AnjaDj/2D_Space_Mapping/2DSpaceMapping_C/Testing/PCB voltages test/3V3 on PCB - 2.jpg

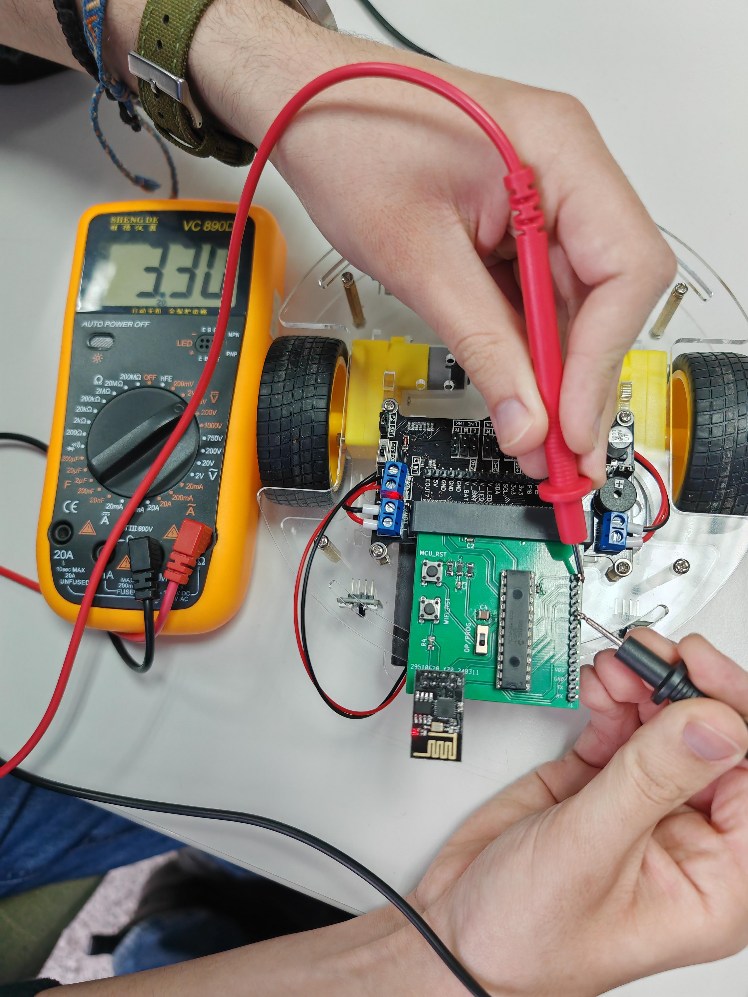
2DSpaceMapping_C/Testing/PCB voltages test/3V3 on PCB - 2.jpg
