AnjaDj/2D_Space_Mapping/README.md

Project Assignment "2D Space Mapping car with ability to move through a maze"
- obstacle detection
- avoiding obstacles
- 2D space mapping
