AnjaDj/2D_Space_Mapping/2DSpaceMapping_C/README.md

# 2DSpaceMapping autonomous vehicle 🚗 ➡️ HARDWARE SIDE

This is a hardware_branch which contains models for assembly electronic devices/ modules / components. <br />
For more detailed informations about each used modul, visit Wiki 📜 page. <br />
 <br />
## Currently implemented :
  - edge connector
  - MCU PIC24FJ64GA002-I/SP
  - normally opened button TS02-66-50-BK-100-SCR-D
  - WiFi module WRL-17146
  - Slide-Switch SLW-883935-2A-D
  - 2x4 pin socket for WiFi module 5-534206-4
  - MCU socket 1-2199298-9

## Guidance through file hierarchy :
  - Symbols_footprints ➡️ contains .kicad_sym & .kicad_mod files for each used modul / component on the scheme
  - pcb ➡️  contains .png screenshots of .kicad_pcb file
  - schema ➡️  contains .png screenshots of .kicad_sch file and .pdf file exported from KiCad project
  - work ➡️  project work directory. Run ♻️ the pcb_layout_c.kicad_pro form this directory using KiCad7.0 or latest. <br /> (KiCad DOWNLOAD link 🆓⬇️ : https://www.kicad.org/download/windows/)
  - components.csv ➡️ list of used components for this project with Mouser Electronics 🐁 link to each of them. <br /> (https://hr.mouser.com/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)

## KiCad Schema : 
schema
schema_left
schema_right

## KiCad PCB Layout: 
pcb

## KiCad 3D View PCB :
pcb3DView
pcb3DView2

## Guidance through Git Bash commands :
1. 		git checkout hardware_branch
2. 		git pull origin hardware_branch
3. 🚧 ...modification... 🚧
4. 		git add .
5. 		git commit -m "Issue#n
   		- Line1
   		- Line2
   		- ..."
     n  - the number of Issue being worked on
7. 		git push origin hardware_branch
