AnjaDj/2D_Space_Mapping/2DSpaceMapping_B/docs/pcb/layout_3d_model.pdf

Projektni zadatak iz predmeta Mikrokontrolerski sistemi/Računarska elektronika

1

### Elektrotehnički fakultet Univerzitet u Banjoj Luci

## DOKUMENTACIJA PROJEKTNOG ZADATKA

## iz predmeta

## MIKROKONTROLERSKI SISTEMI/RAČUNARSKA ELEKTRONIKA

Student: | Mentori:
Tripić, Nemanja | prof. dr Željko Ivanović
Legenović, Dajana | dipl. inž Damjan Prerad
Savković, Božana

Projektni zadatak iz predmeta Digitalna obrada signala - izvještaj

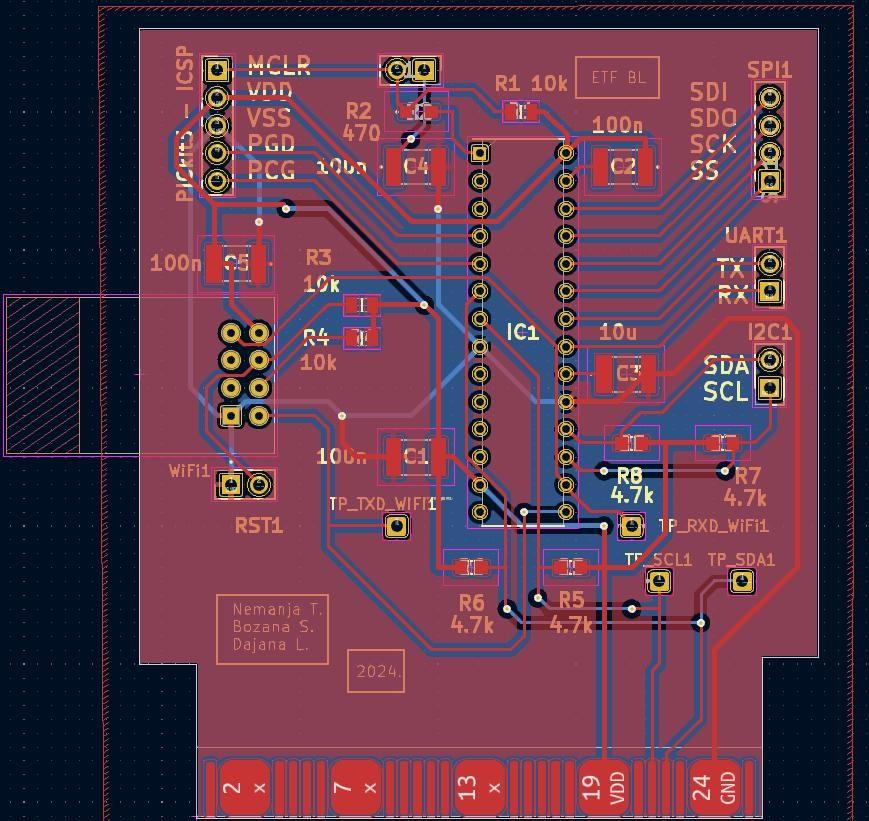
[picture p3: figure]

2

## RUTIRANJE KOMPONENATA

## Rutiranje komponenata

Nakon projektovanja šeme, potrebno je odraditi PCB layuot, rutirati komponente. Korišeno je dvoslojno rutiranje. Debljine linija za povezivanje su 0.254mm, a za napajanje 0.5mm. Minimalno rastojanje između komponenata je 0.1mm.

## Layout

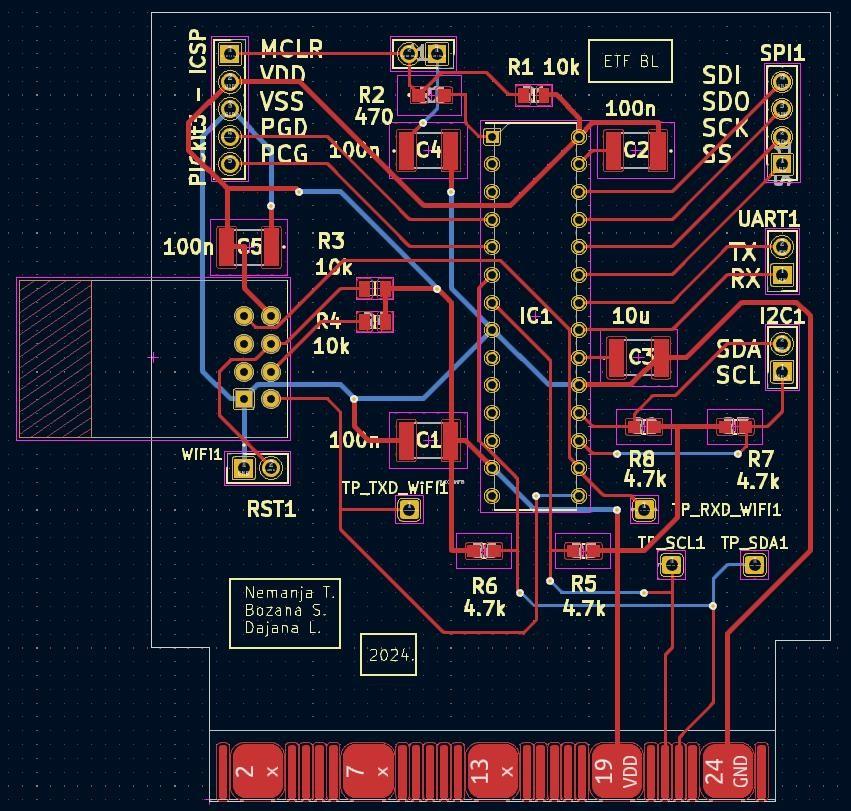
[picture p4: figure]

3

Prednja strana:

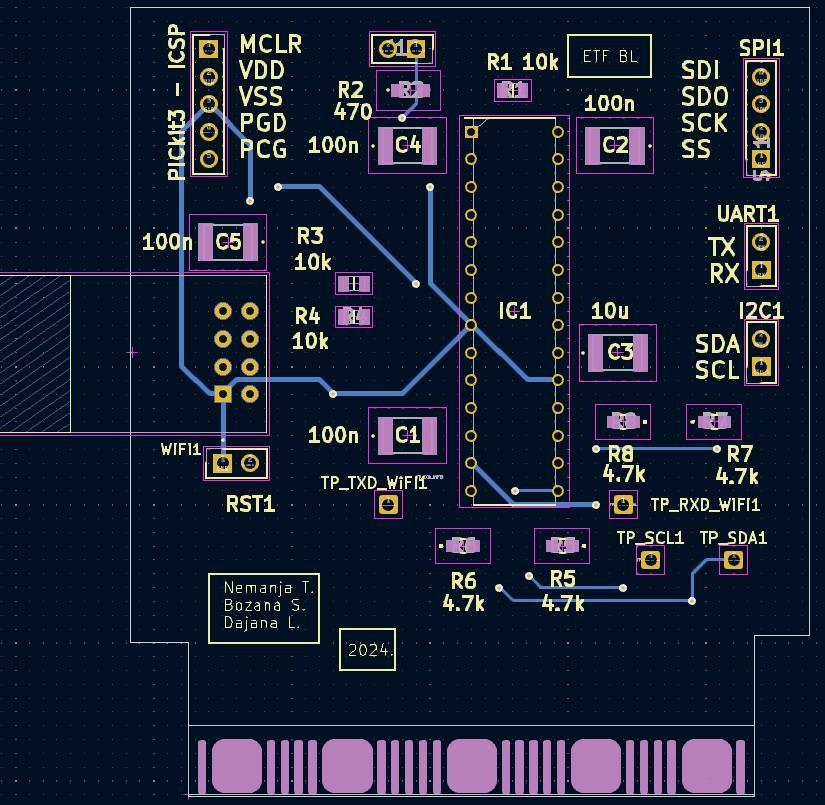
[picture p5: figure]

4

Zadnja strana:

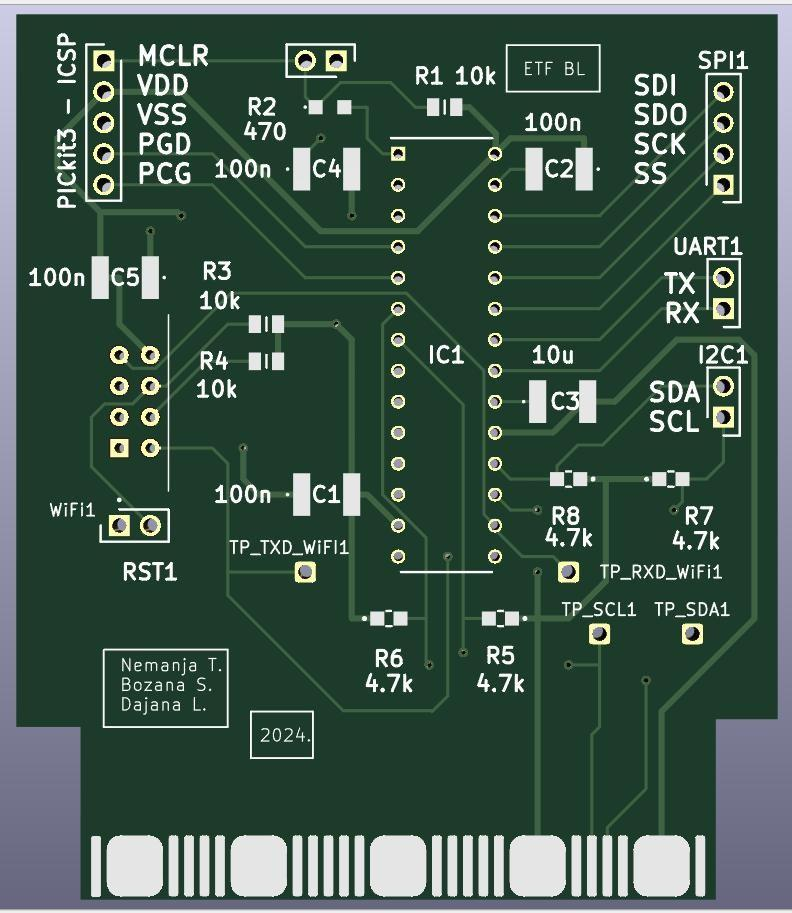
[picture p6: figure]

5

## 3D MODEL

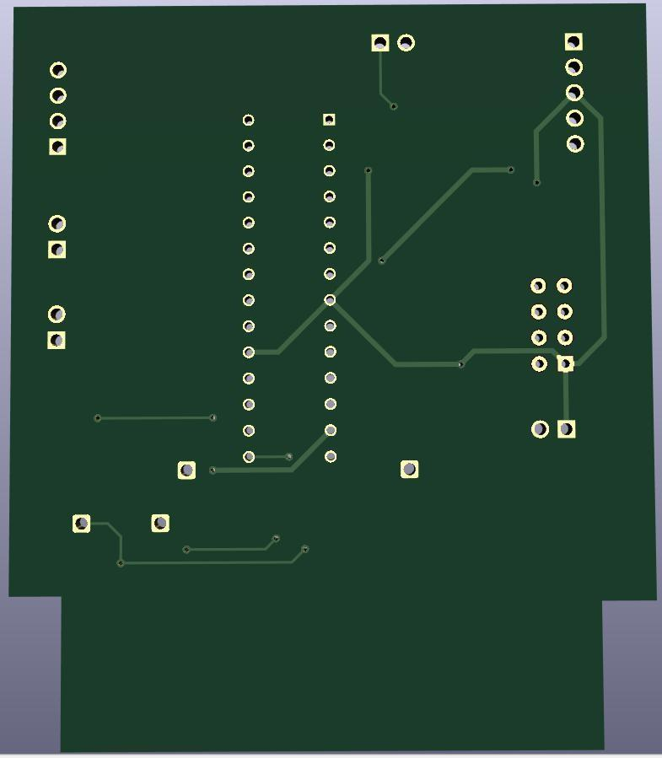
[picture p7: figure]

6

7
