AnjaDj/2D_Space_Mapping/2DSpaceMapping_B/software/2D_mapping_simulation/map1.png

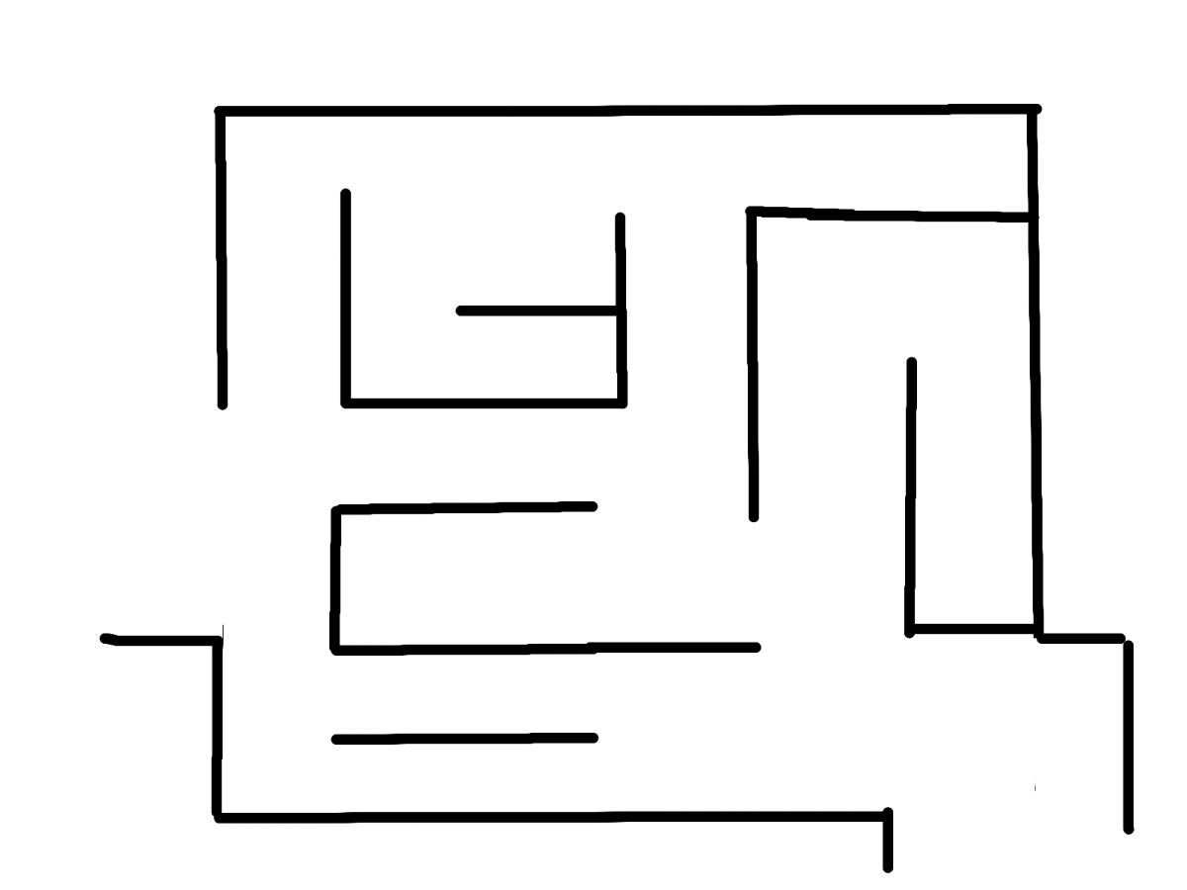
2DSpaceMapping_B/software/2D_mapping_simulation/map1.png
