AnjaDj/2D_Space_Mapping/2DSpaceMapping_C/pcb/pcb3DView2.png

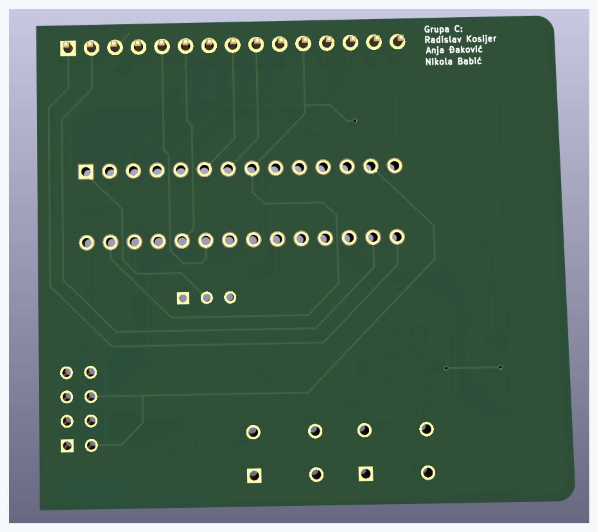
2DSpaceMapping_C/pcb/pcb3DView2.png
