AnjaDj/2D_Space_Mapping/2DSpaceMapping_C/pcb/pcb.png

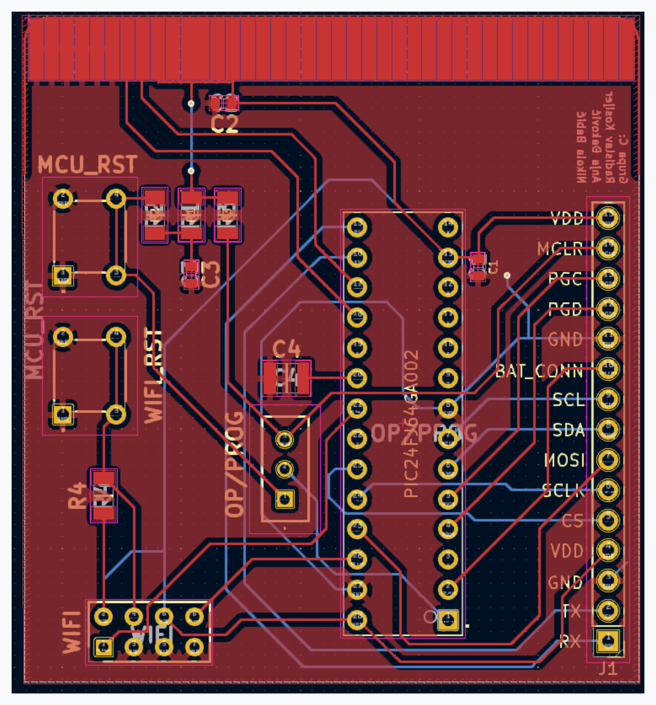
2DSpaceMapping_C/pcb/pcb.png
