AnjaDj/2D_Space_Mapping/2DSpaceMapping_C/schema/schema.png

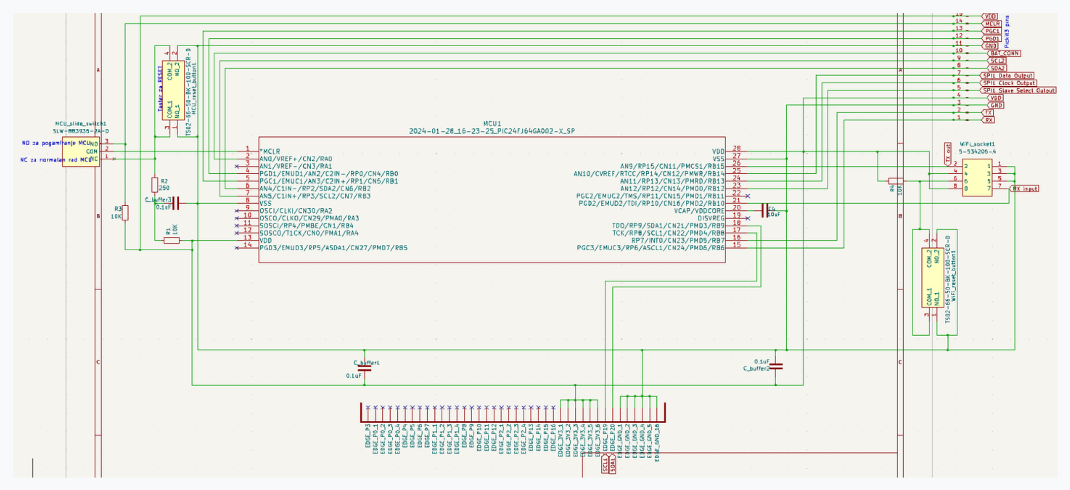
2DSpaceMapping_C/schema/schema.png
