AnjaDj/2D_Space_Mapping/2DSpaceMapping_C/schema/schema_right.png

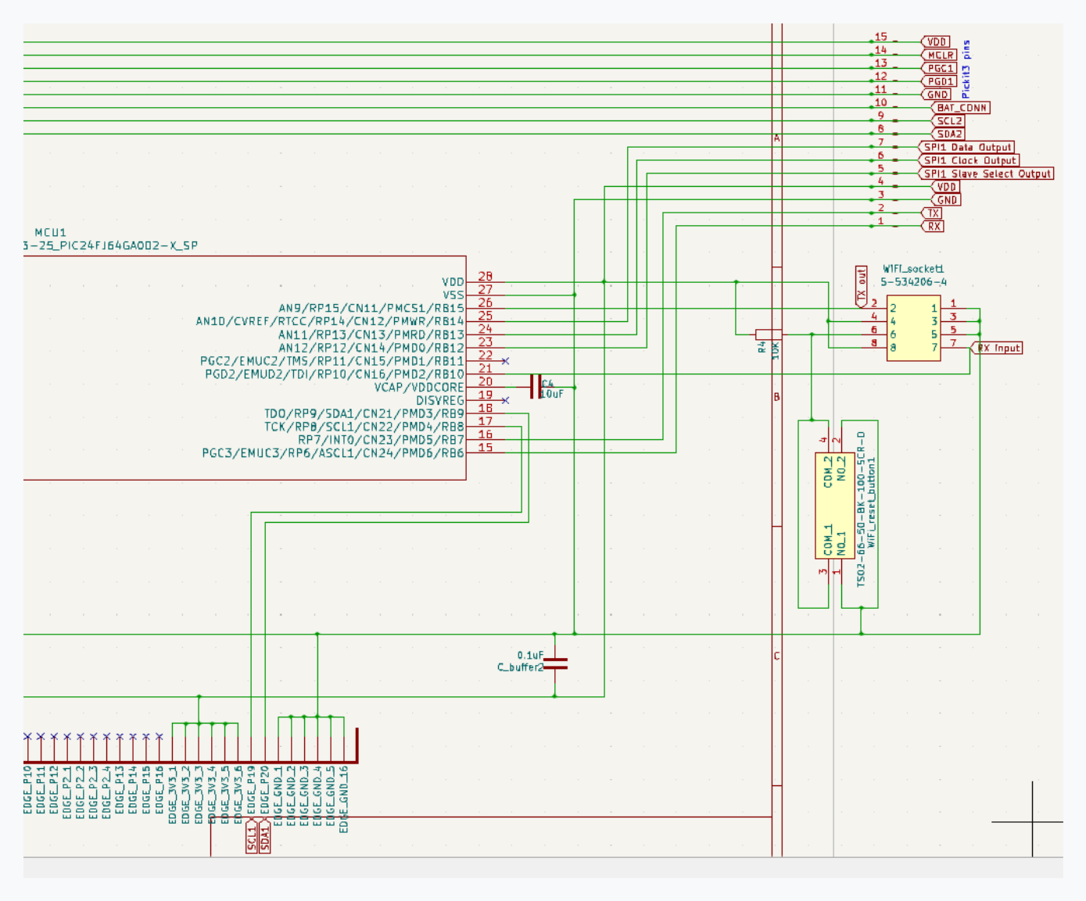
2DSpaceMapping_C/schema/schema_right.png
