AnjaDj/2D_Space_Mapping/2DSpaceMapping_A/kicad/sema_i_pcb/models/CAPACITORS_RESISTORS/100nF.stp

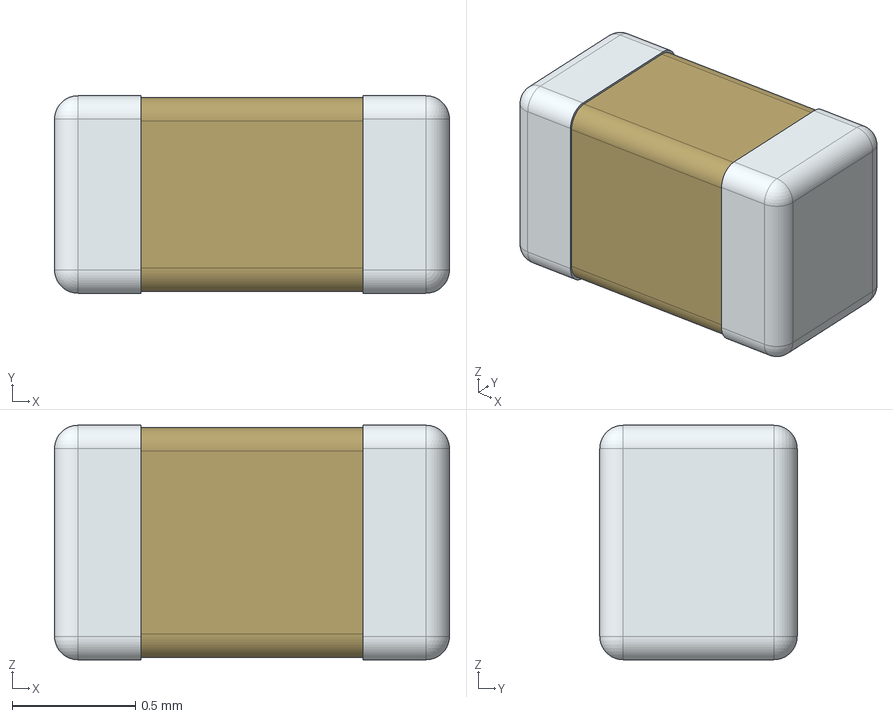
[picture p25: CAD file, 2024-08-02]
2DSpaceMapping_A/kicad/sema_i_pcb/models/CAPACITORS_RESISTORS/100nF.stp
1.60 x 0.8 x 0.95 mm
