AnjaDj/2D_Space_Mapping/2DSpaceMapping_A/kicad/sema_i_pcb/models/ESP8266/ESP8266-01_ESP-01.step

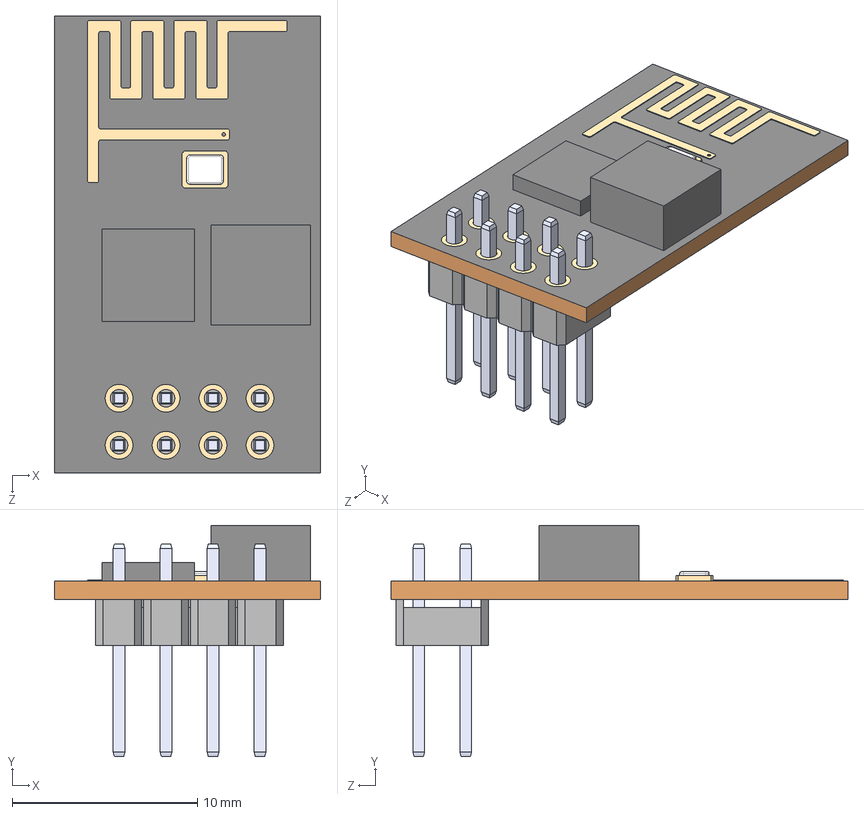
[picture p26: CAD file, 2024-08-02]
2DSpaceMapping_A/kicad/sema_i_pcb/models/ESP8266/ESP8266-01_ESP-01.step
14.4 x 12.5 x 24.7 mm
