AnjaDj/2D_Space_Mapping/2DSpaceMapping_A/kicad/sema_i_pcb/models/MCU/PIC24FJ64GA002-I_SO.STEP

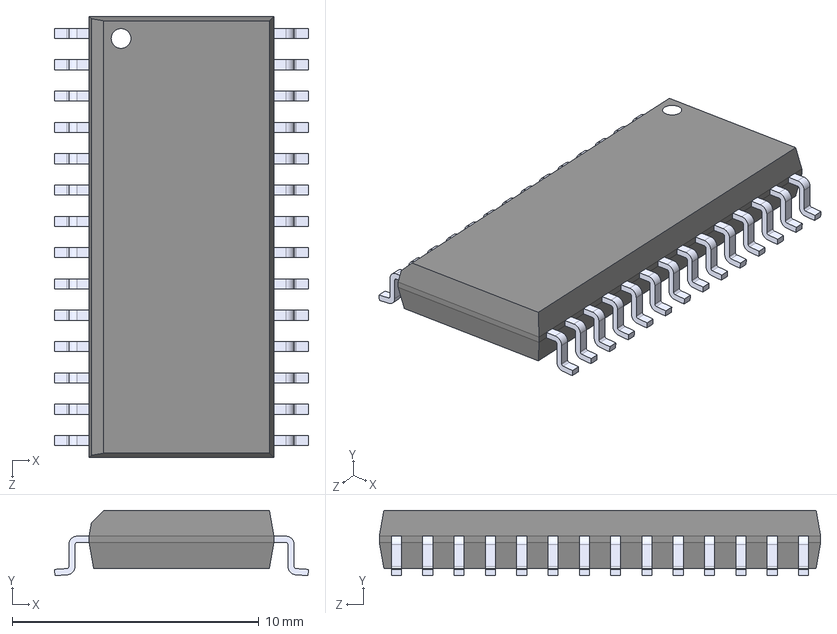
[picture p27: CAD file, 2024-08-02]
2DSpaceMapping_A/kicad/sema_i_pcb/models/MCU/PIC24FJ64GA002-I_SO.STEP
10.3 x 2.65 x 17.9 mm
