AnjaDj/2D_Space_Mapping/2DSpaceMapping_A/kicad/sema_i_pcb/models/PIN_HEADERS/A2-2PA-2.54DSA_71_.stp

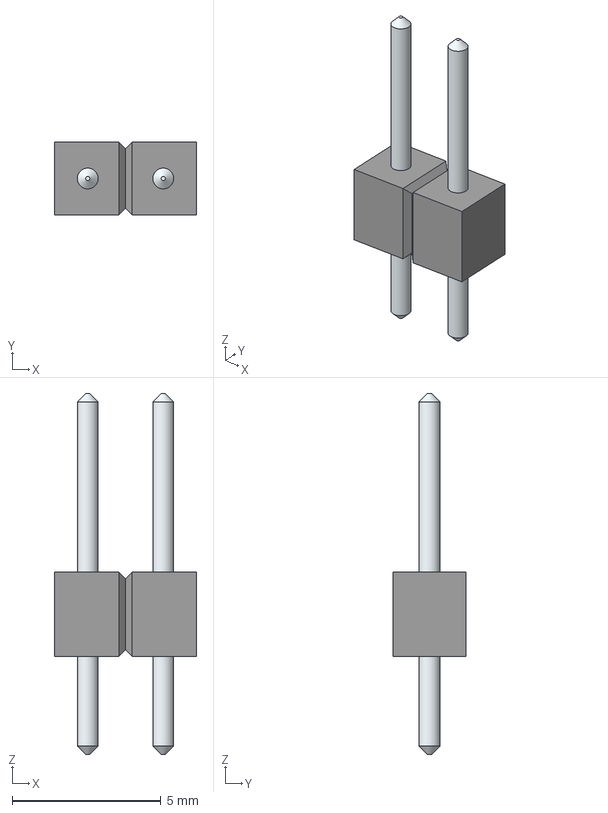
[picture p28: CAD file, 2024-08-02]
2DSpaceMapping_A/kicad/sema_i_pcb/models/PIN_HEADERS/A2-2PA-2.54DSA_71_.stp
4.78 x 2.44 x 12.1 mm
LeadsArray
