AnjaDj/2D_Space_Mapping/2DSpaceMapping_A/kicad/sema_i_pcb/models/PUSH_BUTTON/COM-12992.stp

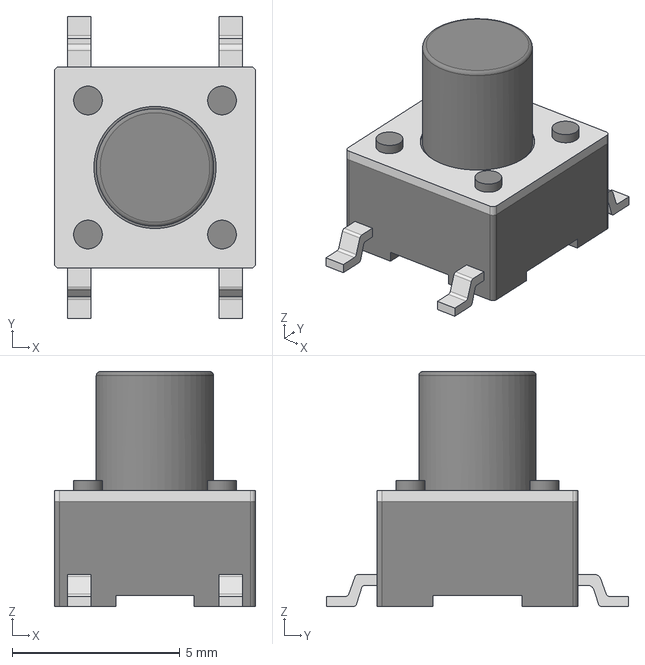
[picture p29: CAD file, 2024-08-02]
2DSpaceMapping_A/kicad/sema_i_pcb/models/PUSH_BUTTON/COM-12992.stp
6.00 x 9.00 x 7.00 mm
