AnjaDj/2D_Space_Mapping/2DSpaceMapping_A/kicad/sema_i_pcb/models/SPDT_SWITCH/SLW-1276864-4A-D.stp

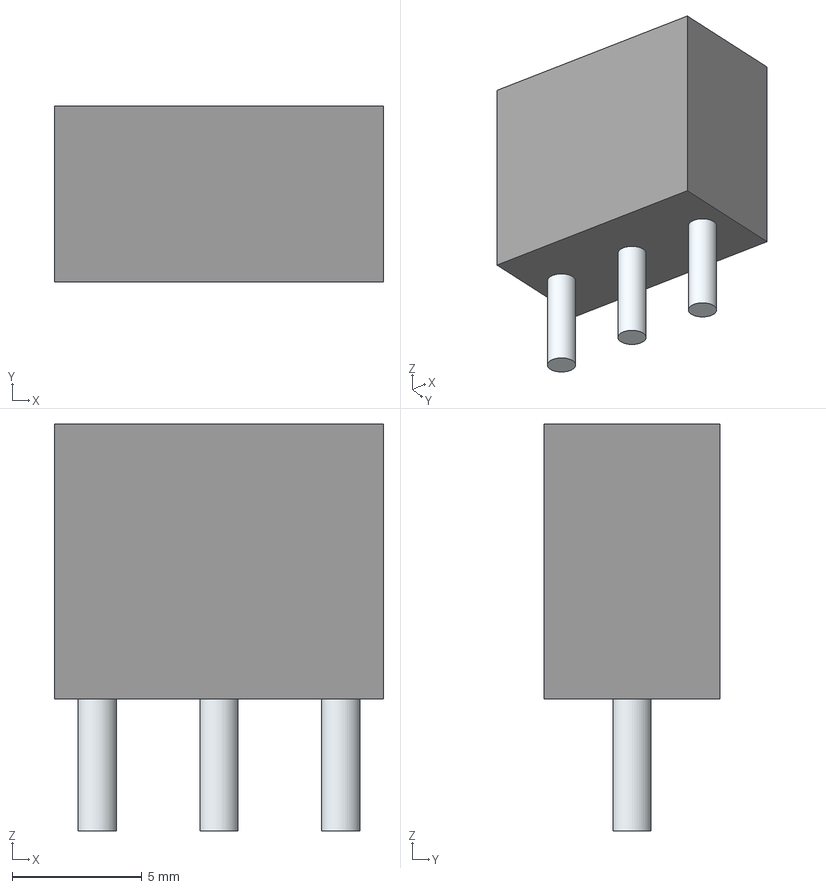
[picture p30: CAD file, 2024-08-02]
2DSpaceMapping_A/kicad/sema_i_pcb/models/SPDT_SWITCH/SLW-1276864-4A-D.stp
12.7 x 6.80 x 15.7 mm
Leads
