AnjaDj/2D_Space_Mapping/2DSpaceMapping_C/Symbols_footprints/mcu_socket_1-2199298-9/1-2199298-9.step

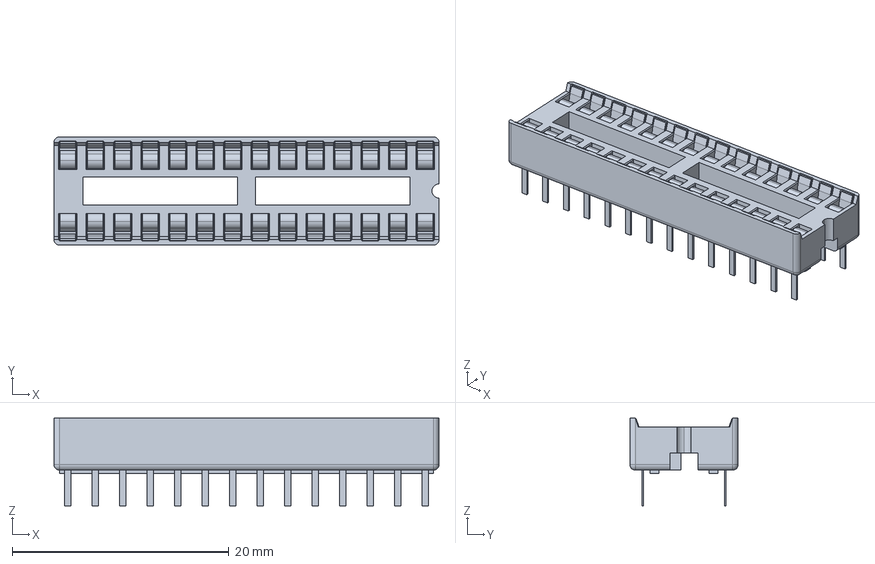
[picture p31: CAD file, 2024-08-02]
2DSpaceMapping_C/Symbols_footprints/mcu_socket_1-2199298-9/1-2199298-9.step
35.6 x 10.0 x 8.10 mm
