AnjaDj/2D_Space_Mapping/2DSpaceMapping_A/kicad/sema_i_pcb/models/CAPACITORS_RESISTORS/10k.stp

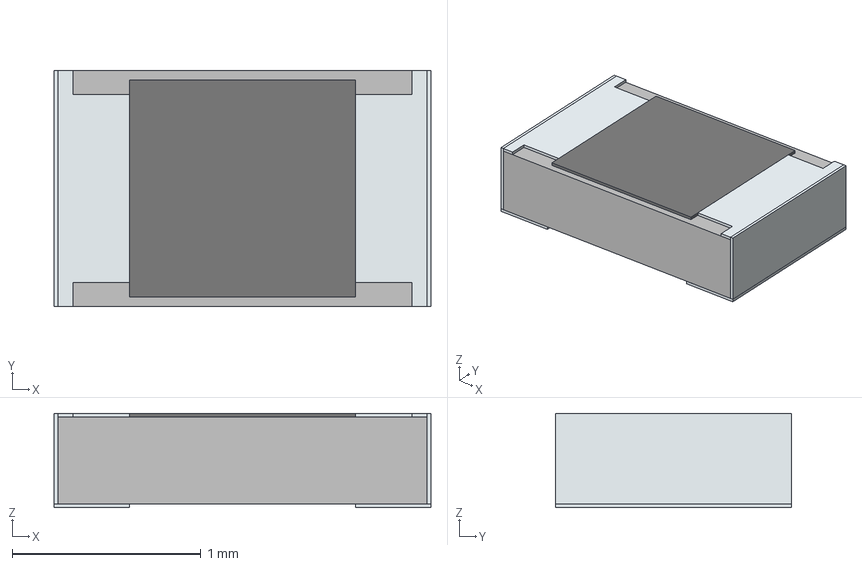
[picture p32: CAD file, 2024-08-02]
2DSpaceMapping_A/kicad/sema_i_pcb/models/CAPACITORS_RESISTORS/10k.stp
2.00 x 1.25 x 0.5 mm
solidBody
solidTop
solidTerminal1
solidTerminal2
solidTerminal3
