AnjaDj/2D_Space_Mapping/2DSpaceMapping_A/kicad/sema_i_pcb/models/PIN_HEADERS/A2-4PA-2.54DSA_71_.stp

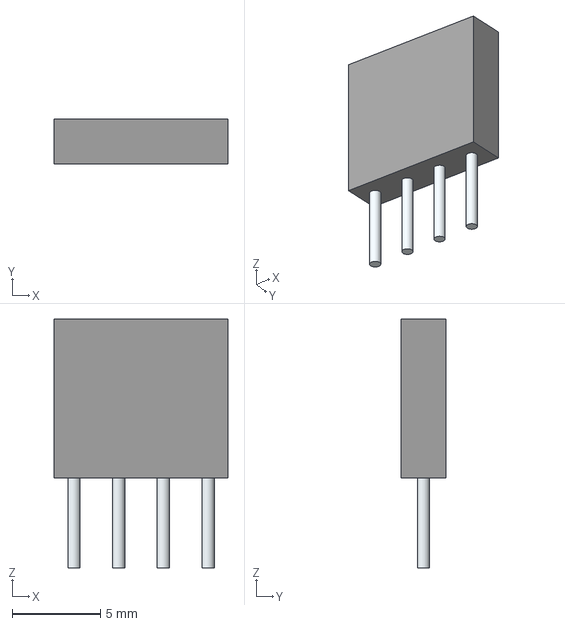
[picture p33: CAD file, 2024-08-02]
2DSpaceMapping_A/kicad/sema_i_pcb/models/PIN_HEADERS/A2-4PA-2.54DSA_71_.stp
9.86 x 2.54 x 14.1 mm
Leads x 4
