AnjaDj/2D_Space_Mapping/2DSpaceMapping_A/kicad/sema_i_pcb/models/CAPACITORS_RESISTORS/10uF.stp

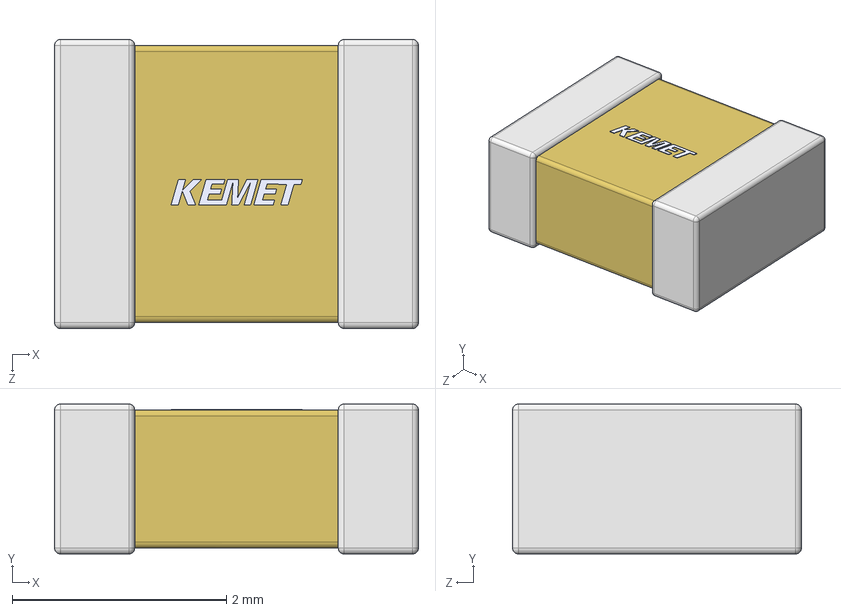
[picture p34: CAD file, 2024-08-02]
2DSpaceMapping_A/kicad/sema_i_pcb/models/CAPACITORS_RESISTORS/10uF.stp
3.40 x 1.40 x 2.70 mm
