AnjaDj/2D_Space_Mapping/2DSpaceMapping_A/kicad/sema_i_pcb/models/PIN_HEADERS/A2-5PA-2.54DSA_71_.stp

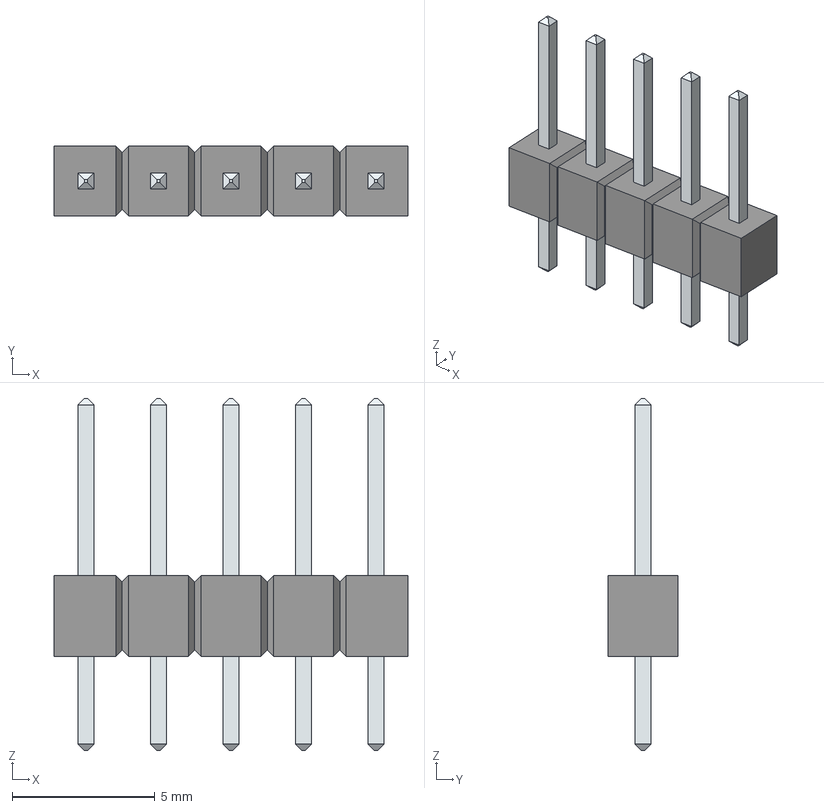
[picture p35: CAD file, 2024-08-02]
2DSpaceMapping_A/kicad/sema_i_pcb/models/PIN_HEADERS/A2-5PA-2.54DSA_71_.stp
12.4 x 2.44 x 12.3 mm
LeadsArray
