AnjaDj/2D_Space_Mapping/2DSpaceMapping_C/Testing/PCB voltages test/3V3 on Joy-Car board.jpg

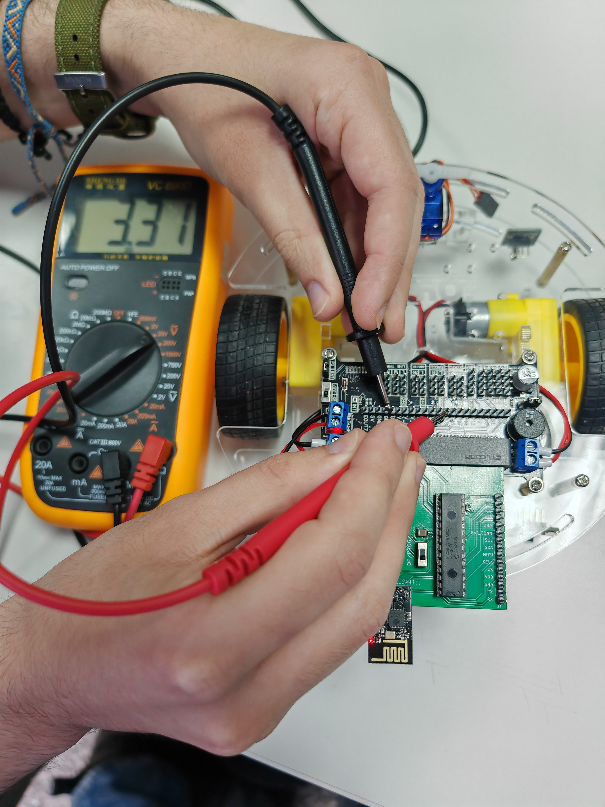
2DSpaceMapping_C/Testing/PCB voltages test/3V3 on Joy-Car board.jpg
