AnjaDj/2D_Space_Mapping/2DSpaceMapping_C/shema_layout_3dview.pdf

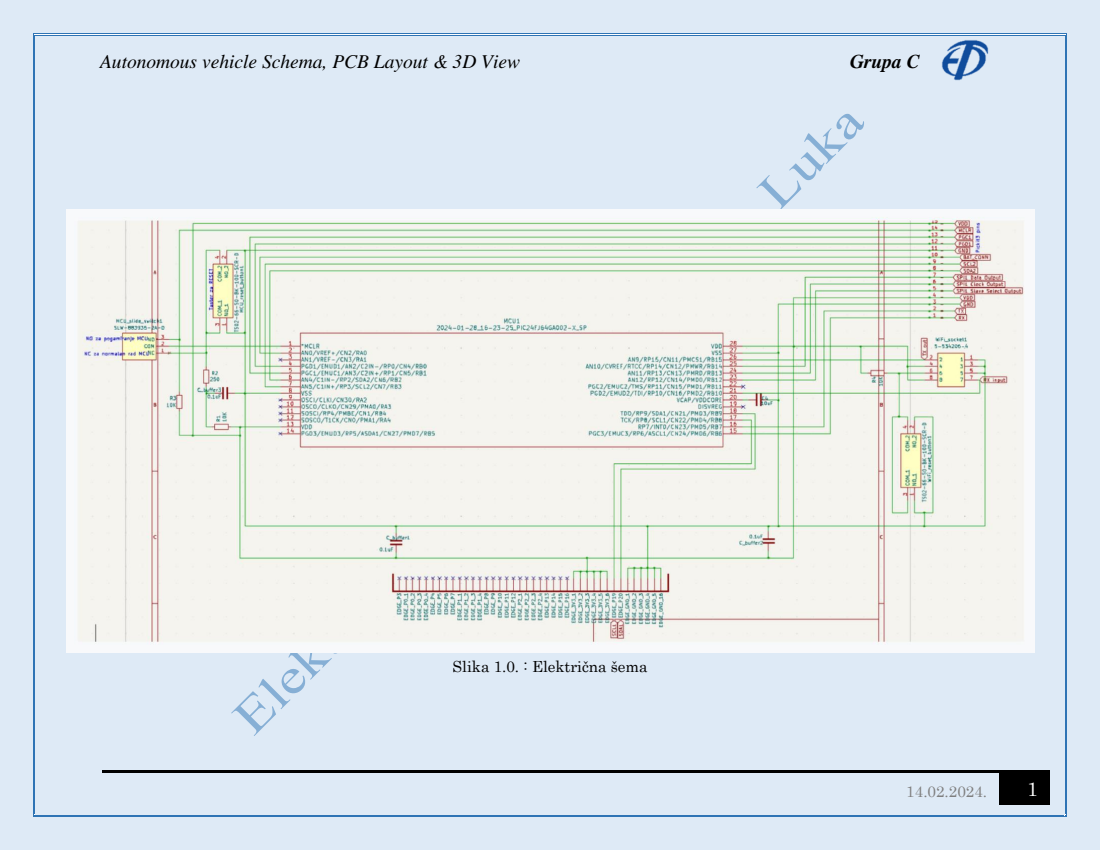
[picture p38: page 1]
Autonomous vehicle Schema, PCB Layout & 3D View; Grupa C

Slika 1.0. : Električna šema

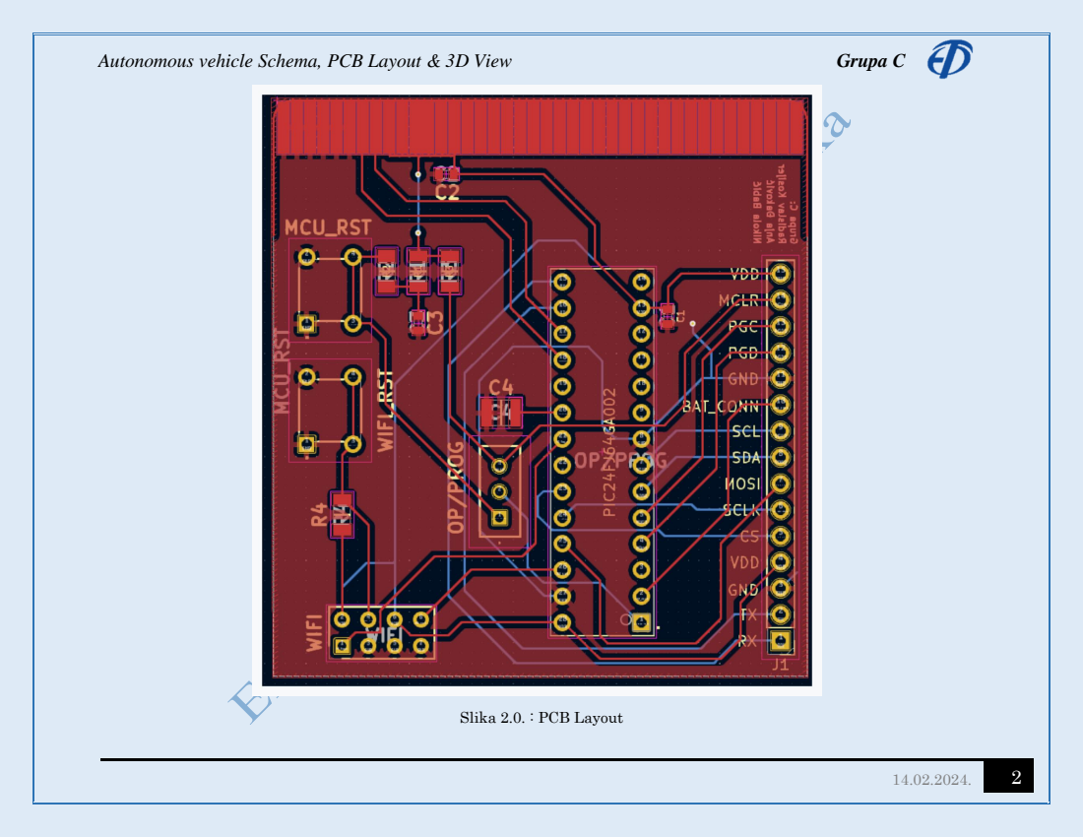
[picture p39: page 2]

Slika 2.0. : PCB Layout

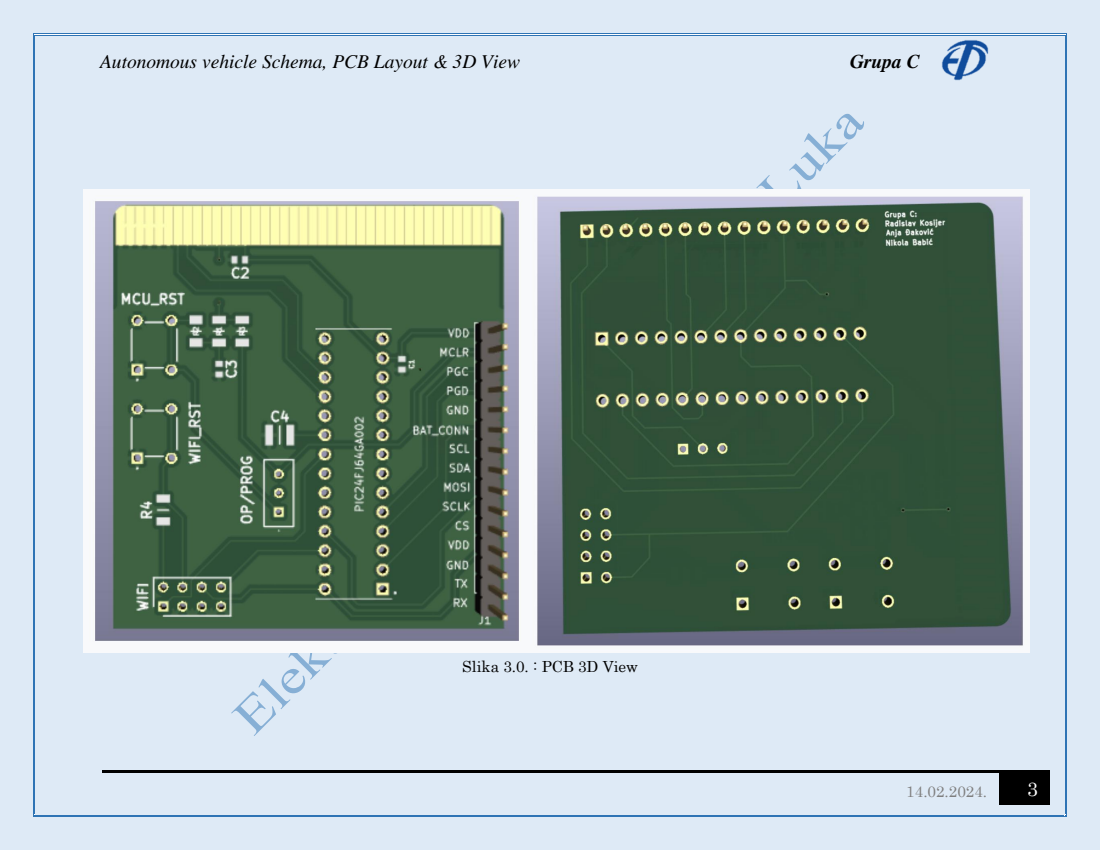
[picture p40: page 3]

Slika 3.0. : PCB 3D View
