AnjaDj/2D_Space_Mapping/2DSpaceMapping_B/docs/pcb/kompletna_sema.pdf

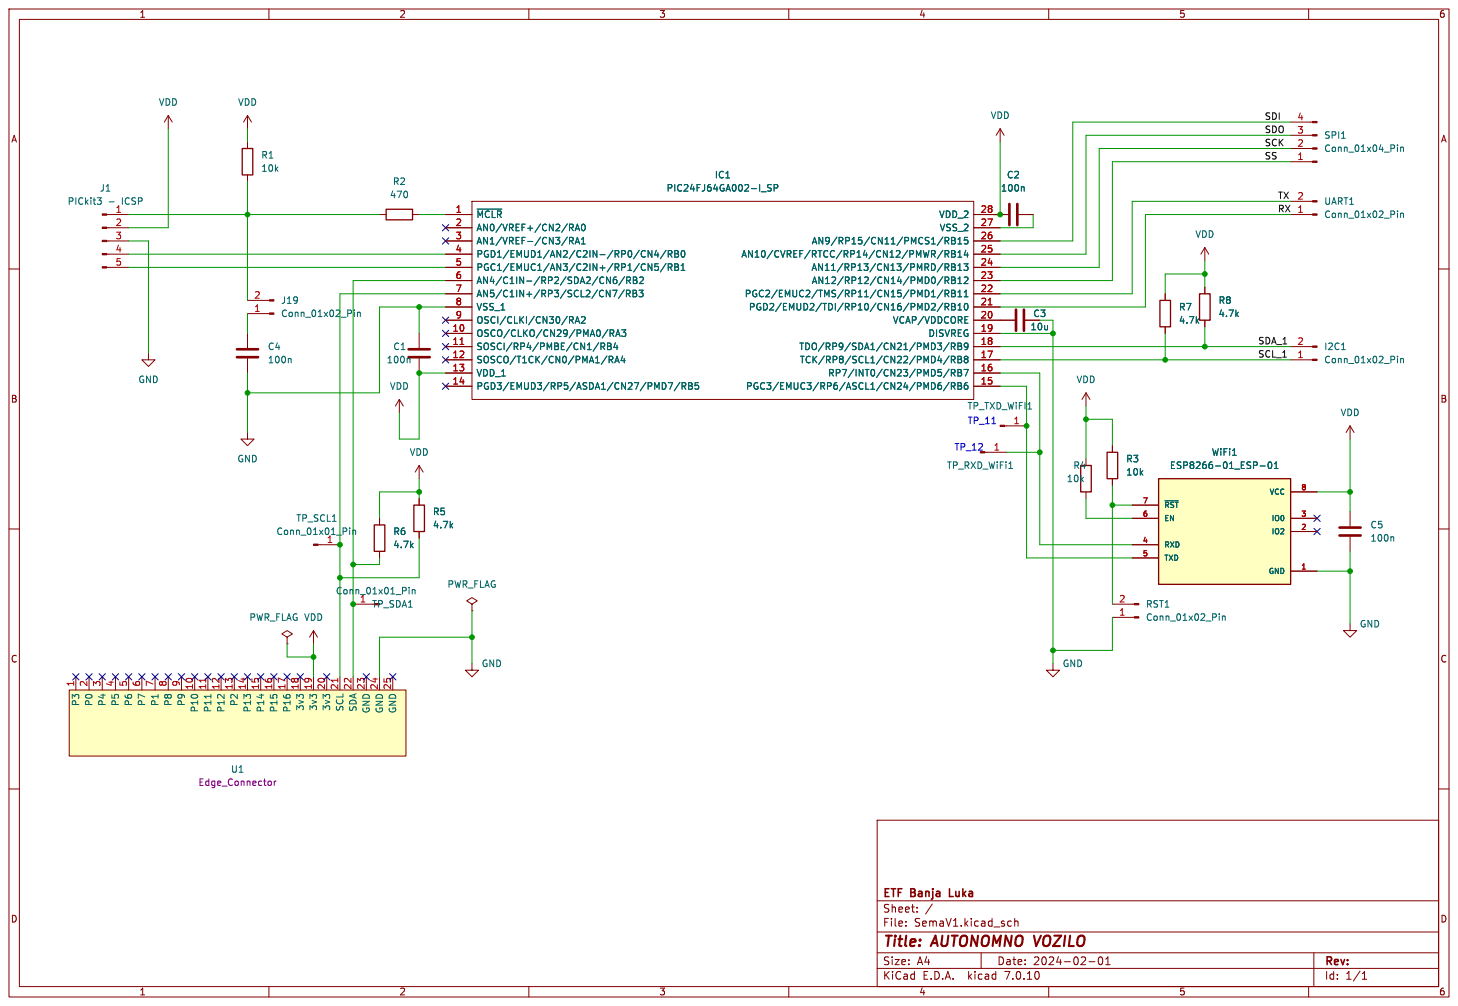
[picture p41: page 1]

2 3v3 20 SCL 21 SDA 22 GND 23 GND 24 GND 25 P4

Id: 1/1 Title: AUTONOMNO VOZILO
