AnjaDj/2D_Space_Mapping/2DSpaceMapping_C/schema/pcb_layout_c.pdf

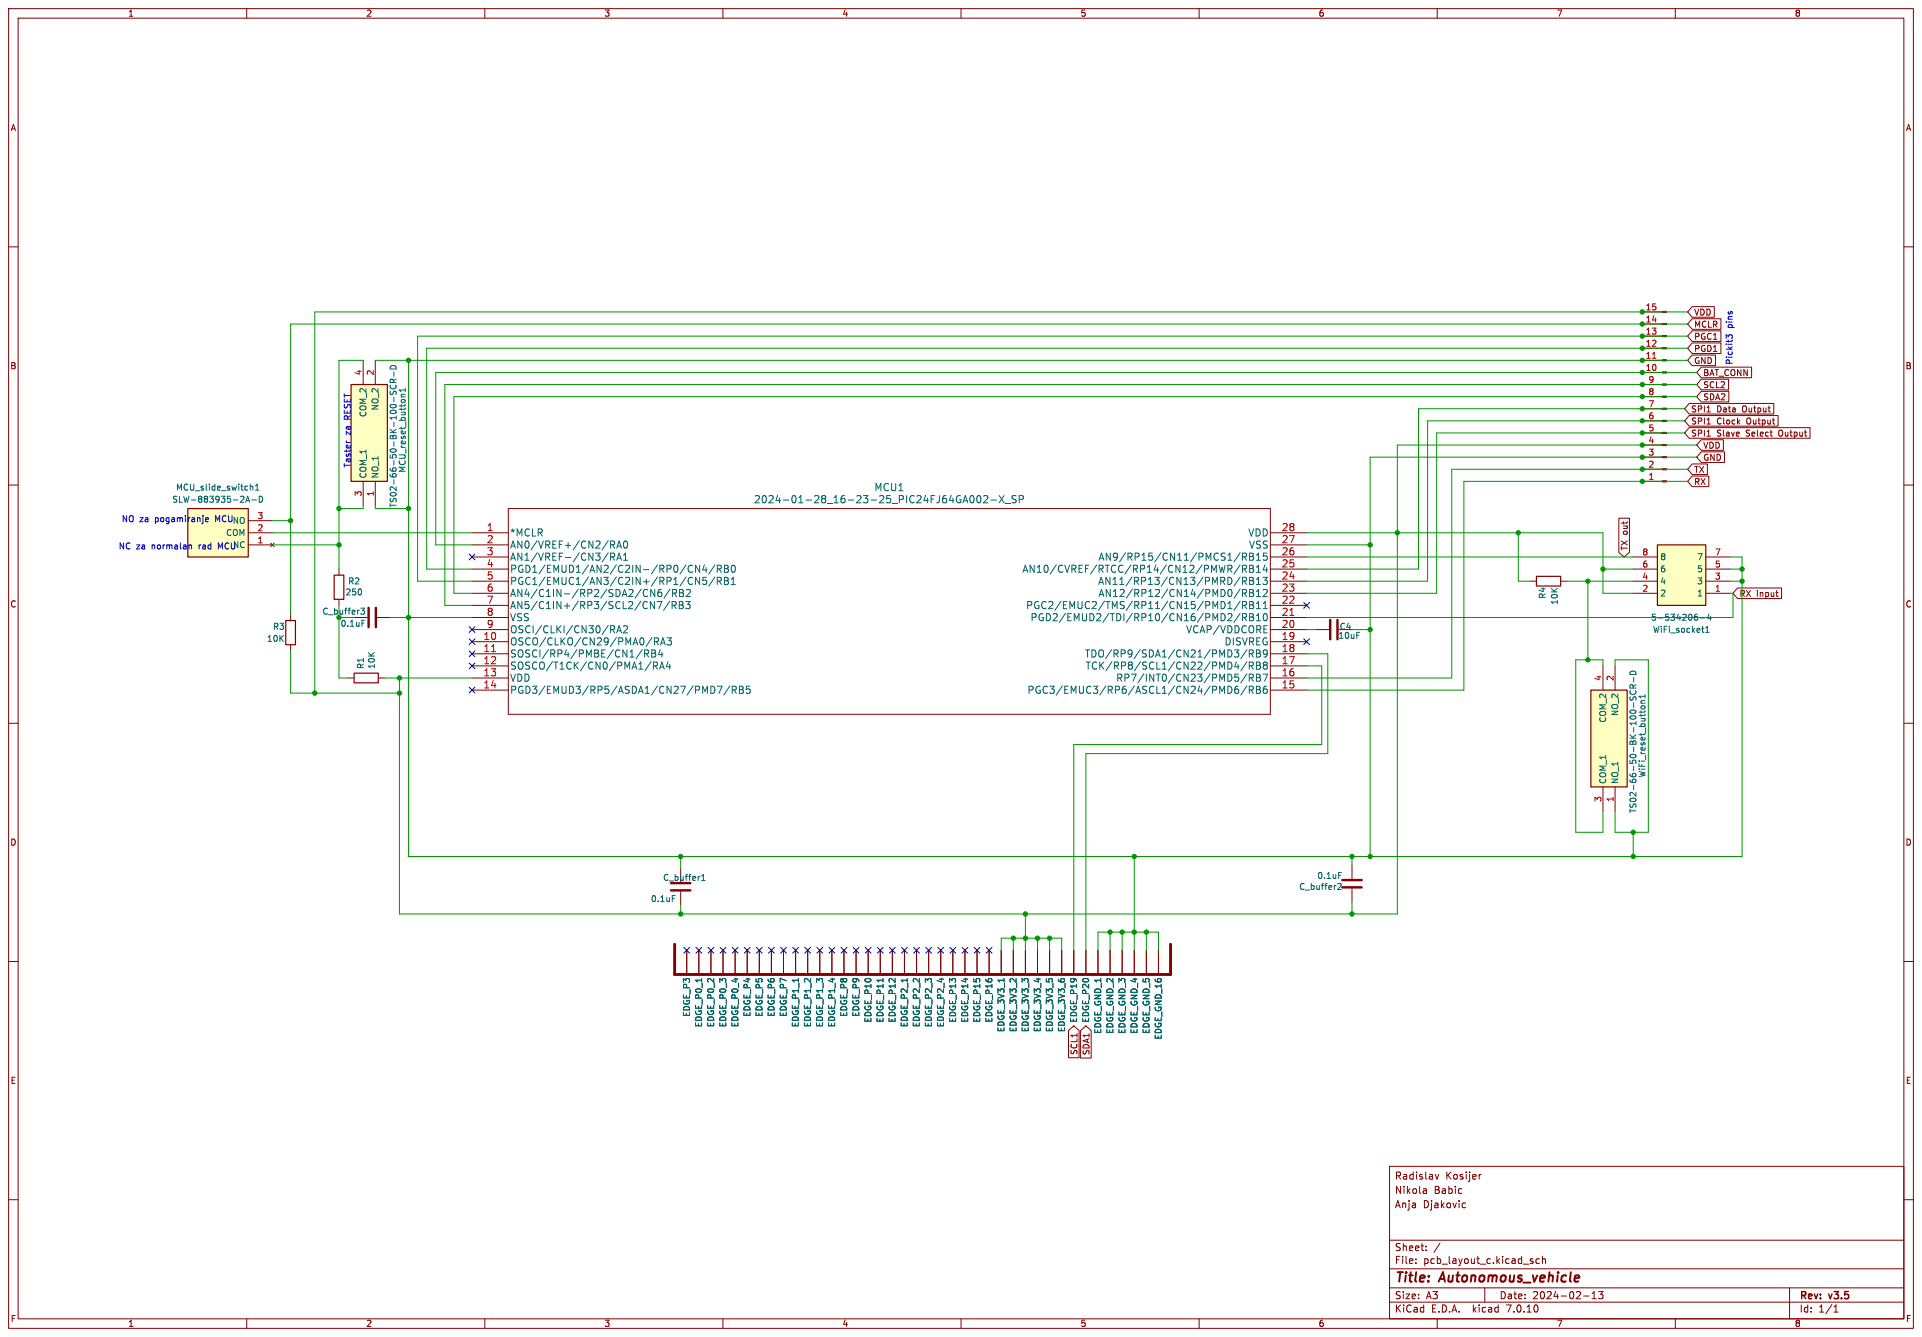
[picture p42: page 1]

SPI1 Slave Select Output SPI1 Clock Output VDD
