AnjaDj/2D_Space_Mapping/2DSpaceMapping_C/Symbols_footprints/edge_connector/dimenzije_edge_connector.pdf

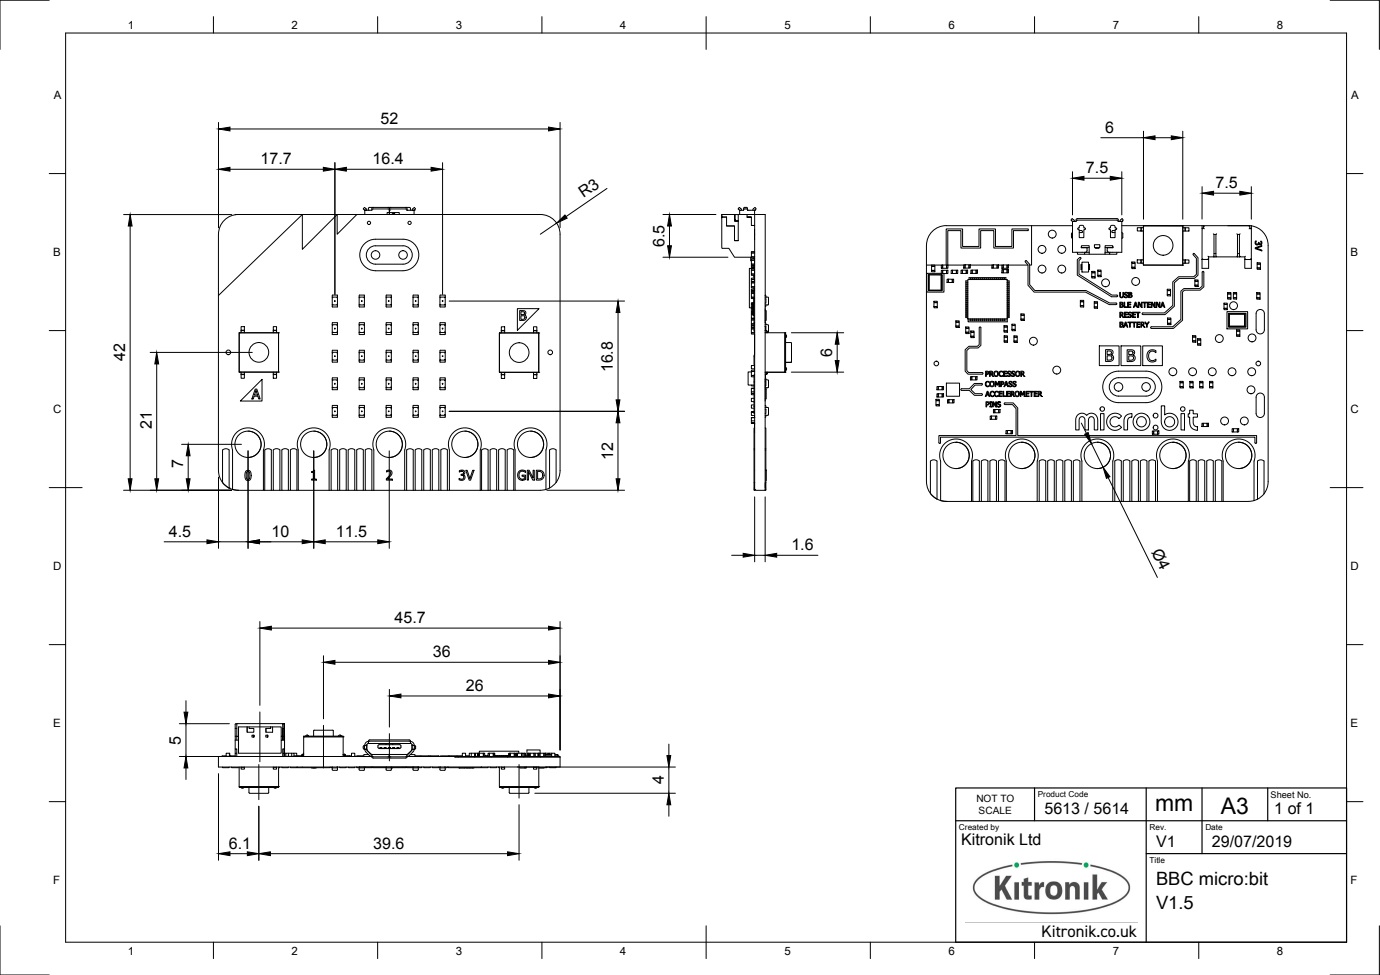
[picture p43: page 1]
BBC micro:bit

SCALE | Product Code 5613 / 5614 | mm | A3 | Sheet No. NOT TO 1 of 1

Created by Kitronik Ltd Kitronik.co.uk | | Rev. V1 | Date 29/07/2019
