AnjaDj/2D_Space_Mapping/2DSpaceMapping_B/pcb_design/kicad_schematic_pcb/control_board.kicad_pcb

## KiCad design 2DSpaceMapping_B/pcb_design/kicad_schematic_pcb/control_board.kicad_pcb (2024-08-02)

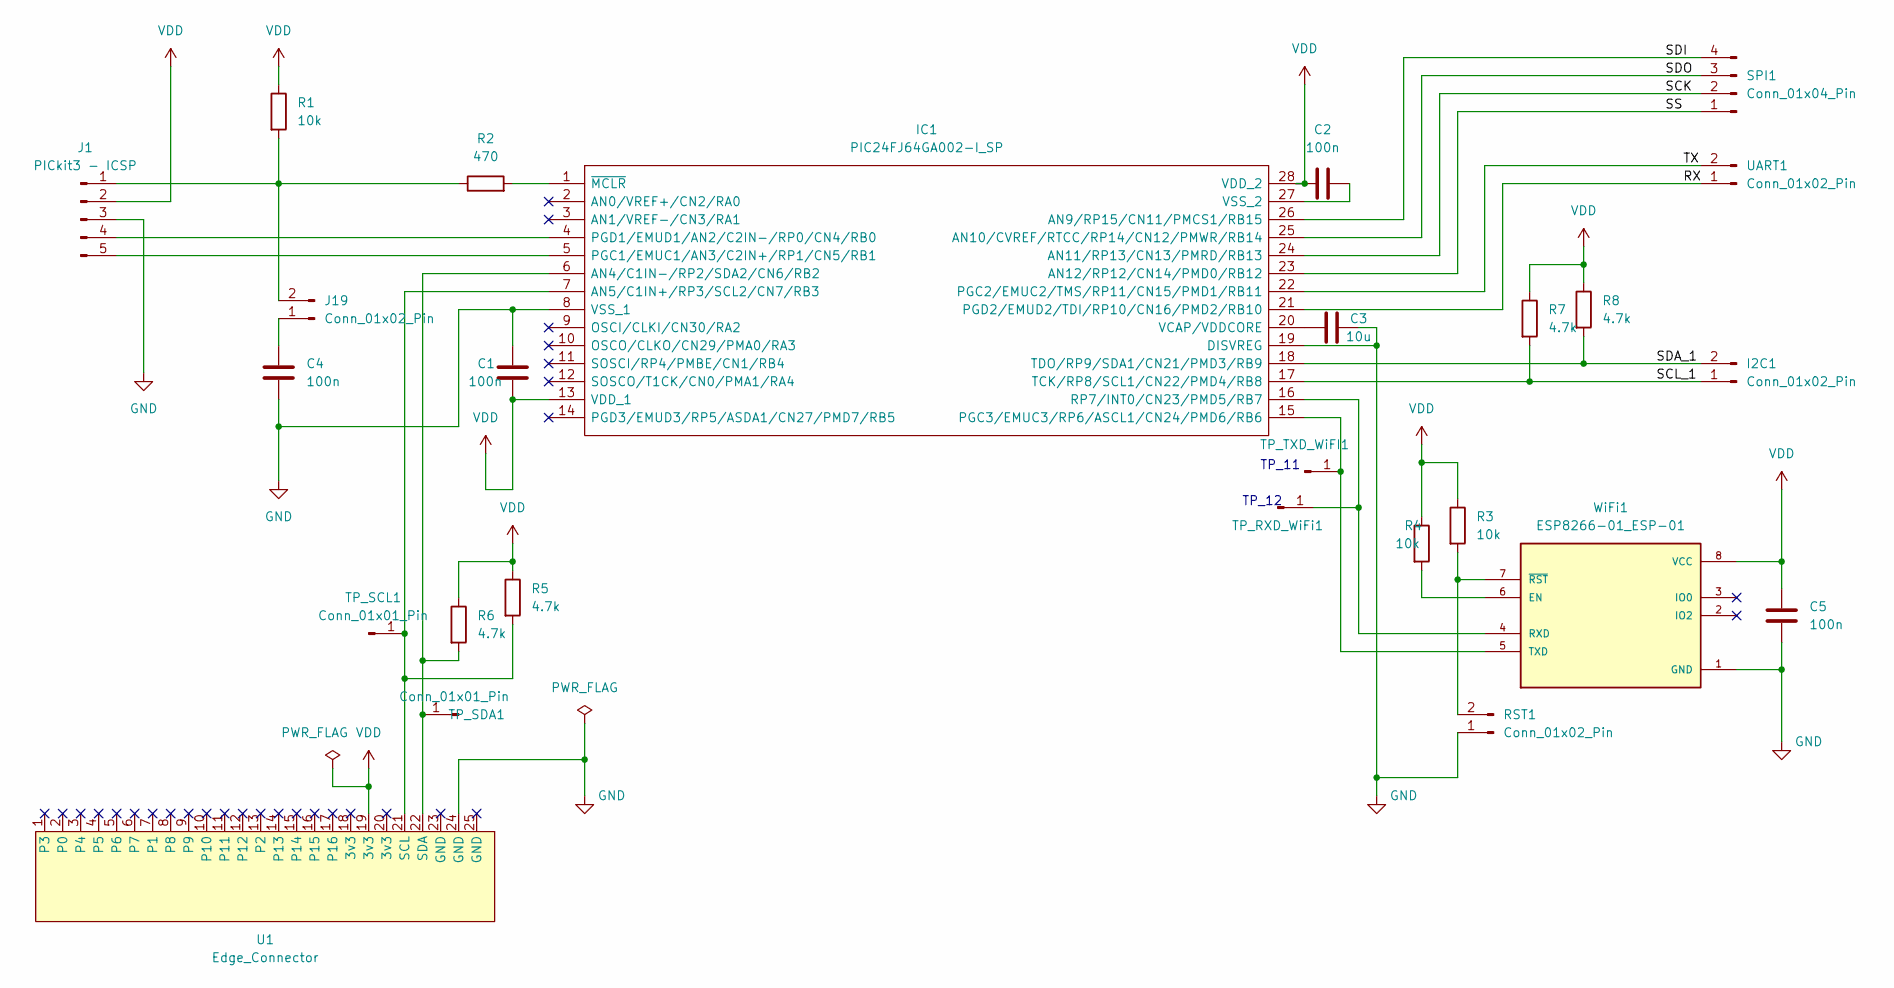
[picture p44: schematic control_board.kicad_sch, AUTONOMNO VOZILO]

Parts:
C1, C2, C4, C5: 100n; C1812
C3: 10u; C1812
I2C1: Conn_01x02_Pin; HDRV2W66P0X254_1X2_508X254X874P
IC1: PIC24FJ64GA002-I_SP; DIP794W56P254L3486H508Q28N; Mouser Part Number 579-PIC24FJ64GA002SP
J1: PICkit3 - ICSP; HDRV5W67P0X254_1X5_1229X234X821P
J19: Conn_01x02_Pin; HDRV2W66P0X254_1X2_508X254X874P
R1, R3, R4: 10k; RESC2012X65N
R2: 470; ERA6VK
R5, R6, R7, R8: 4.7k; ERA6AEB1020V
RST1: Conn_01x02_Pin; HDRV2W66P0X254_1X2_508X254X874P
SPI1: Conn_01x04_Pin; HDRV4W64P0X254_1X4_1016X254X889P
TP_RXD_WiFi1: Conn_01x01_Pin; SolderWire-0.1sqmm_1x01_D0.4mm_OD1mm
TP_SCL1: Conn_01x01_Pin; SolderWire-0.1sqmm_1x01_D0.4mm_OD1mm
TP_SDA1: Conn_01x01_Pin; SolderWire-0.1sqmm_1x01_D0.4mm_OD1mm
TP_TXD_WiFI1: Conn_01x01_Pin; SolderWire-0.1sqmm_1x01_D0.4mm_OD1mm
U1: Edge_Connector
UART1: Conn_01x02_Pin; HDRV2W66P0X254_1X2_508X254X874P
WiFi1: ESP8266-01_ESP-01; XCVR_ESP8266-01_ESP-01; PARTREV V1.2

Connections:
/RX: IC1.21 (PGD2/EMUD2/TDI/RP10/CN16/PMD2/RB10), UART1.1
/SCK: IC1.24 (AN11/RP13/CN13/PMRD/RB13), SPI1.2
/SCL_1: I2C1.1, IC1.17 (TCK/RP8/SCL1/CN22/PMD4/RB8), R7.2
/SDA_1: I2C1.2, IC1.18 (TDO/RP9/SDA1/CN21/PMD3/RB9), R8.2
/SDI: IC1.26 (AN9/RP15/CN11/PMCS1/RB15), SPI1.4
/SDO: IC1.25 (AN10/CVREF/RTCC/RP14/CN12/PMWR/RB14), SPI1.3
/SS: IC1.23 (AN12/RP12/CN14/PMD0/RB12), SPI1.1
/TX: IC1.22 (PGC2/EMUC2/TMS/RP11/CN15/PMD1/RB11), UART1.2
GND: C1.1, C3.2, C4.2, C5.1, IC1.8 (VSS_1), IC1.19 (DISVREG), J1.3, RST1.1, U1.24 (GND), WiFi1.1 (GND)
unnamed: IC1.6 (AN4/C1IN-/RP2/SDA2/CN6/RB2), R6.2, TP_SDA1.1, U1.22 (SDA)
unnamed: IC1.7 (AN5/C1IN+/RP3/SCL2/CN7/RB3), R5.2, TP_SCL1.1, U1.21 (SCL)
unnamed: IC1.5 (PGC1/EMUC1/AN3/C2IN+/RP1/CN5/RB1), J1.5
unnamed: IC1.15 (PGC3/EMUC3/RP6/ASCL1/CN24/PMD6/RB6), TP_TXD_WiFI1.1, WiFi1.5 (TXD)
unnamed: IC1.4 (PGD1/EMUD1/AN2/C2IN-/RP0/CN4/RB0), J1.4
unnamed: IC1.16 (RP7/INT0/CN23/PMD5/RB7), TP_RXD_WiFi1.1, WiFi1.4 (RXD)
unnamed: C3.1, IC1.20 (VCAP/VDDCORE)
unnamed: C2.2, IC1.27 (VSS_2)
unnamed: IC1.1 (~MCLR), R2.2
unnamed: J1.1, J19.2, R1.2, R2.1
unnamed: C4.1, J19.1
unnamed: R3.2, RST1.2, WiFi1.7 (~RST)
unnamed: R4.2, WiFi1.6 (EN)
VDD: C1.2, C2.1, C5.2, IC1.13 (VDD_1), IC1.28 (VDD_2), J1.2, R1.1, R3.1, R4.1, R5.1, R6.1, R7.1, R8.1, U1.19 (3v3), WiFi1.8 (VCC)

Notes on the sheet:
TP_12
TP_11

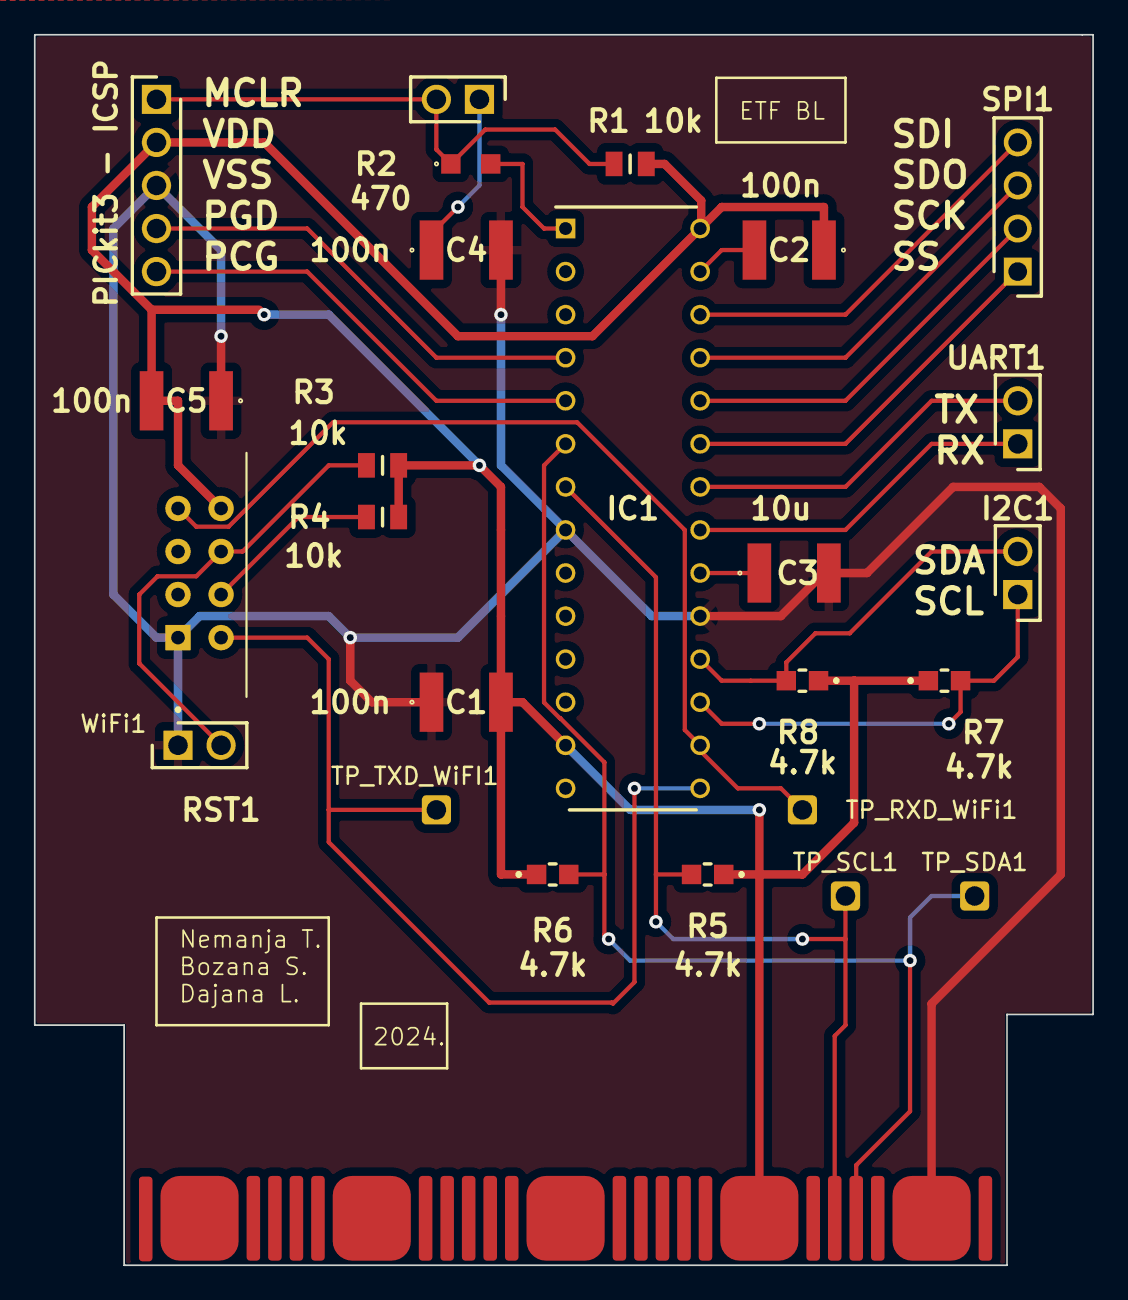
[picture p45: board control_board.kicad_pcb from above]

Board: 2 copper layers, 62.4 x 72.6 mm, 26 parts (0 on the bottom side), 23 nets.
