AnjaDj/2D_Space_Mapping/2DSpaceMapping_A/kicad/sema_i_pcb/sema_i_pcb.kicad_pcb

## KiCad design 2DSpaceMapping_A/kicad/sema_i_pcb/sema_i_pcb.kicad_pcb (2024-08-02)

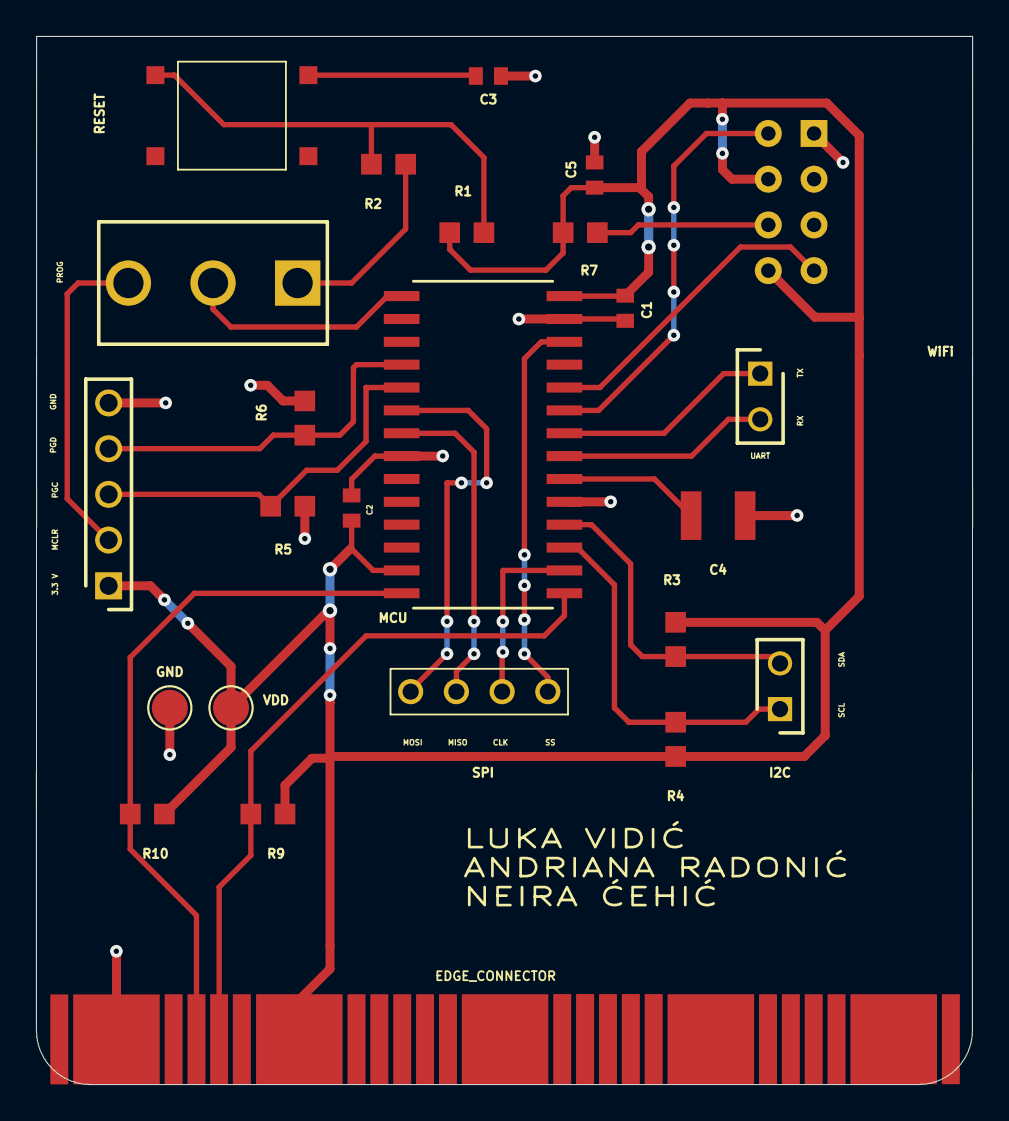
[picture p46: board sema_i_pcb.kicad_pcb from above]

Board: 2 copper layers, 52.0 x 58.2 mm, 25 parts (0 on the bottom side), 23 nets.

Parts:
C1, C2, C3, C5: 100n; 100nF
C4: 10u; 10uF
EDGE_CONNECTOR: edge_connector
GND: GND; TestPoint_Pad_D2.0mm
I2C: Conn_01x02_Pin; HDRV2W70P0X254_1X2_478X244X884P
MCU: PIC24FJ64GA002-E_SO; SOIC28-W_MC_MCH
PICkit_Conn1: Conn_01x05_Pin; HDRV5W56P0X254_1X5_1240X244X904P
PROG: SW_SPDT; SLW12768644AD
R1, R5, R6, R7: ERA6AEB1020V; 10k
R2: ERA6AEB1020V; 330R
R3, R4, R9, R10: 4.7k; 4k7
RESET: COM-12992; COM12992
SPI: Conn_01x04_Pin; A24PA254DSA71
U2: ESP8266-01_ESP-01; XCVR_ESP8266-01_ESP-01
UART: Conn_01x02_Pin; HDRV2W70P0X254_1X2_478X244X884P
VDD: VCC; TestPoint_Pad_D2.0mm

Connections:
+3.3V: C1.1, C2.1, C5.1, EDGE_CONNECTOR.7 (3.3_V), MCU.13 (VDD), MCU.28 (VDD), PICkit_Conn1.1, R1.1, R3.1, R4.1, R7.1, R9.1, R10.1, U2.6 (EN), U2.8 (VCC), VDD.1
/I2C_SCL: I2C.1, MCU.17 (TCK/RP8/SCL1/CN22/PMD4/RB8), R4.2
/I2C_SDA: I2C.2, MCU.18 (TDO/RP9/SDA1/CN21/PMD3/RB9), R3.2
/MCLR: MCU.1 (~MCLR), PROG.2 (B)
/PGC: MCU.5 (PGC1/EMUC1/AN3/C2IN+/RP1/CN5/RB1), PICkit_Conn1.3, R5.1
/PGD: MCU.4 (PGD1/EMUD1/AN2/C2IN-/RP0/CN4/RB0), PICkit_Conn1.4, R6.1
/SCL_MBIT: EDGE_CONNECTOR.5 (SCL), MCU.15 (PGC3/EMUC3/RP6/ASCL1/CN24/PMD6/RB6), R9.2
/SDA_MBIT: EDGE_CONNECTOR.4 (SDA), MCU.14 (PGD3/EMUD3/RP5/ASDA1/CN27/PMD7/RB5), R10.2
/SPI_CLK: MCU.16 (RP7/INT0/CN23/PMD5/RB7), SPI.3
/SPI_DI: MCU.7 (AN5/C1IN+/RP3/SCL2/CN7/RB3), SPI.2
/SPI_DO: MCU.6 (AN4/C1IN-/RP2/SDA2/CN6/RB2), SPI.1
/SPI_SS: MCU.26 (AN9/RP15/CN11/PMCS1/RB15), SPI.4
/THROW_PROG: PICkit_Conn1.2, PROG.3 (C)
/THROW_RST: PROG.1 (A), R2.2
/UART_RX: MCU.21 (PGD2/EMUD2/TDI/RP10/CN16/PMD2/RB10), UART.2
/UART_RX_WIFI: MCU.24 (AN11/RP13/CN13/PMRD/RB13), U2.4 (RXD)
/UART_TX: MCU.22 (PGC2/EMUC2/TMS/RP11/CN15/PMD1/RB11), UART.1
/UART_TX_WIFI: MCU.23 (AN12/RP12/CN14/PMD0/RB12), U2.5 (TXD)
GND: C1.2, C2.2, C3.2, C4.2, C5.2, EDGE_CONNECTOR.2 (GND), GND.1, MCU.8 (VSS), MCU.19 (DISVREG), MCU.27 (VSS), PICkit_Conn1.5, R5.2, R6.2, U2.1 (GND)
unnamed: C3.1, RESET.B1
unnamed: R1.2, R2.1, RESET.A1
unnamed: C4.1, MCU.20 (VCAP/VDDCORE)
unnamed: R7.2, U2.7 (~RST)
