AnjaDj/2D_Space_Mapping/2DSpaceMapping_C/work/pcb_layout_c/pcb_layout_c.kicad_pcb

## KiCad design 2DSpaceMapping_C/work/pcb_layout_c/pcb_layout_c.kicad_pcb (2024-08-02)

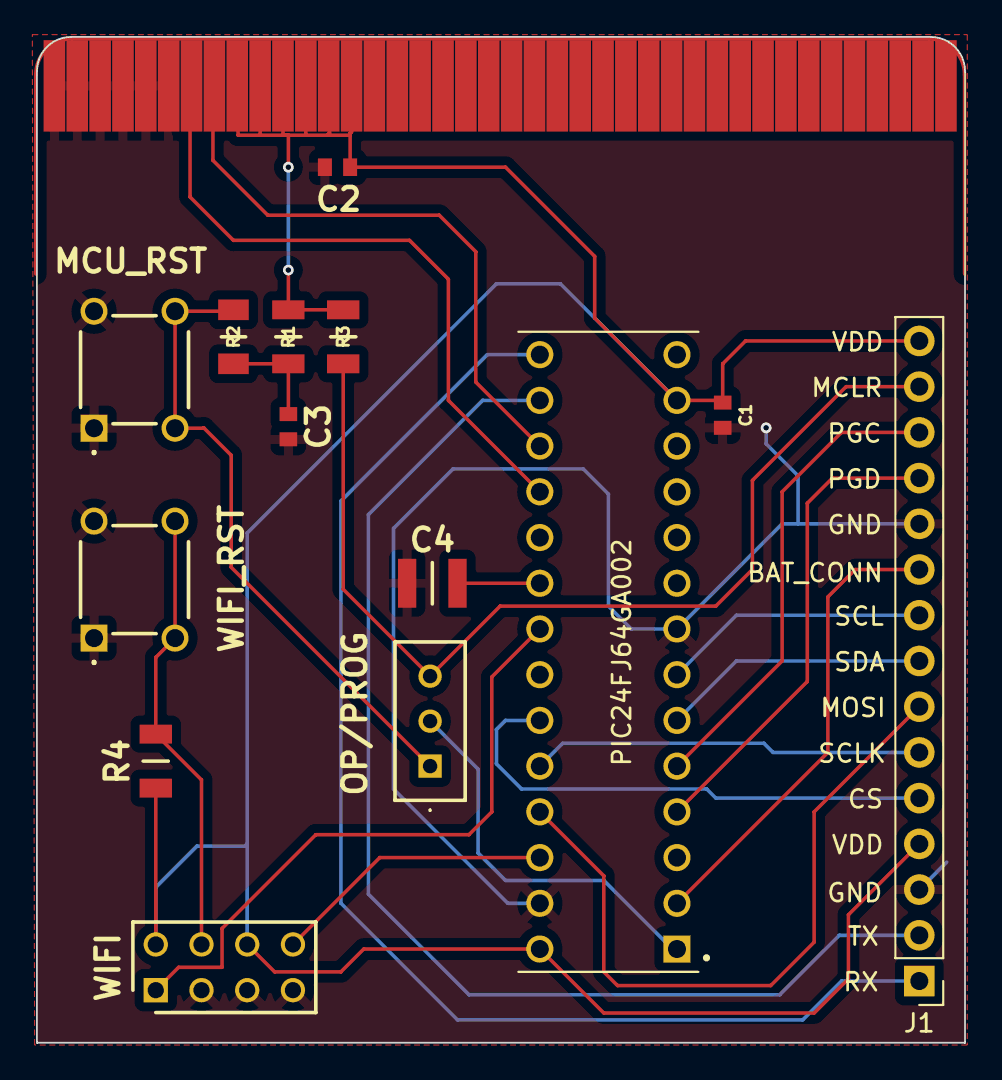
[picture p47: board pcb_layout_c.kicad_pcb from above]

Board: 2 copper layers, 51.6 x 55.9 mm, 15 parts (0 on the bottom side), 22 nets.

Parts:
C1, C2, C3: 0.1uF; CAPC1608X95N
C4: 10uF; CAPC3225X210N
J1: Conn_01x15_Pin; PinHeader_1x15_P2.54mm_Vertical
MCU_RST: TS02-66-50-BK-100-SCR-D; TS026650BK100SCRD
OP/PROG: SLW-883935-2A-D; SLW8839352AD
PIC24FJ64GA002: 2024-01-28_16-23-25_PIC24FJ64GA002-X_SP; DIP762W60P254L3556H510Q28
R1, R3, R4: 10K; RESC3216X60N
R2: 250; RESC3216X70N
WIFI: 5-534206-4; RHDR8W69P254_2X4_1016X503X877P
WIFI_RST: TS02-66-50-BK-100-SCR-D; TS026650BK100SCRD
edge_connector1: edge_connector1; BBC_EDGE

Connections:
BAT_CONN: J1.10, PIC24FJ64GA002.2 (AN0/VREF+/CN2/RA0)
GND: C1.1, C2.2, C3.2, C4.2, J1.3, J1.11, MCU_RST.1 (NO_1), MCU_RST.2 (NO_2), PIC24FJ64GA002.8 (VSS), PIC24FJ64GA002.27 (VSS), WIFI.3, WIFI.5, WIFI.7, WIFI_RST.1 (NO_1), WIFI_RST.2 (NO_2), edge_connector1.P$35 (EDGE_GND_1), edge_connector1.P$36 (EDGE_GND_2), edge_connector1.P$37 (EDGE_GND_3), edge_connector1.P$38 (EDGE_GND_4), edge_connector1.P$39 (EDGE_GND_5), edge_connector1.P$40 (EDGE_GND_16)
MCLR: J1.14, OP/PROG.3 (NO), R3.1
unnamed: C3.1, R1.1, R2.1
unnamed: OP/PROG.2 (COM), PIC24FJ64GA002.1 (*MCLR)
unnamed: PIC24FJ64GA002.17 (TCK/RP8/SCL1/CN22/PMD4/RB8), edge_connector1.P$33 (EDGE_P19)
unnamed: PIC24FJ64GA002.18 (TDO/RP9/SDA1/CN21/PMD3/RB9), edge_connector1.P$34 (EDGE_P20)
unnamed: C4.1, PIC24FJ64GA002.20 (VCAP/VDDCORE)
unnamed: MCU_RST.3 (COM_1), MCU_RST.4 (COM_2), OP/PROG.1 (NC), R2.2
unnamed: R4.2, WIFI.4, WIFI_RST.3 (COM_1), WIFI_RST.4 (COM_2)
PGC1: J1.13, PIC24FJ64GA002.5 (PGC1/EMUC1/AN3/C2IN+/RP1/CN5/RB1)
PGD1: J1.12, PIC24FJ64GA002.4 (PGD1/EMUD1/AN2/C2IN-/RP0/CN4/RB0)
RX: J1.1, PIC24FJ64GA002.15 (PGC3/EMUC3/RP6/ASCL1/CN24/PMD6/RB6)
RX input: PIC24FJ64GA002.21 (PGD2/EMUD2/TDI/RP10/CN16/PMD2/RB10), WIFI.1
SCL2: J1.9, PIC24FJ64GA002.7 (AN5/C1IN+/RP3/SCL2/CN7/RB3)
SDA2: J1.8, PIC24FJ64GA002.6 (AN4/C1IN-/RP2/SDA2/CN6/RB2)
SPI1 Clock Output: J1.6, PIC24FJ64GA002.24 (AN11/RP13/CN13/PMRD/RB13)
SPI1 Data Output: J1.7, PIC24FJ64GA002.25 (AN10/CVREF/RTCC/RP14/CN12/PMWR/RB14)
SPI1 Slave Select Output: J1.5, PIC24FJ64GA002.23 (AN12/RP12/CN14/PMD0/RB12)
TX: J1.2, PIC24FJ64GA002.16 (RP7/INT0/CN23/PMD5/RB7)
TX out: PIC24FJ64GA002.26 (AN9/RP15/CN11/PMCS1/RB15), WIFI.8
VDD: C1.2, C2.1, J1.4, J1.15, PIC24FJ64GA002.13 (VDD), PIC24FJ64GA002.28 (VDD), R1.2, R3.2, R4.1, WIFI.2, WIFI.6, edge_connector1.P$27 (EDGE_3V3_1), edge_connector1.P$28 (EDGE_3V3_2), edge_connector1.P$29 (EDGE_3V3_3), edge_connector1.P$30 (EDGE_3V3_4), edge_connector1.P$31 (EDGE_3V3_5), edge_connector1.P$32 (EDGE_3V3_6)
