AnjaDj/2D_Space_Mapping/2DSpaceMapping_B/firmware/integration/driving_algorithm/car_drive.c

/**
 * @file car_drive.c
 * @brief File containing function definitons for vehicle moving.
 * This file contains several function definition that are needed
 * for driving the the vehicle. There are 5 possible directions of
 * moving: forward, left, full left, right, full right. Alse there is
 * additional directions that is used in some cases: reverse.
 * Since I2C interface is needed for driving the vehicle, there is alse
 * initialization of I2C interface, and function for sending I2C messages.
*/

#include "car_drive.h"

/**
 * @name Macros used in program 
 * @{
*/
/** @brief Macro that defines speed of the vehicle (0-255) */ 
#define SPEED 125
/** @brief I2C address of the device */
#define DEVICE_ADDR 0xE0
/** @} */

/**
 * @name I2C Communication
 * Enable Software I2C communication, through the desired pins
 * @{
*/
sbit Soft_I2C_Sda           at RB2_bit;
sbit Soft_I2C_Scl           at RB3_bit;
sbit Soft_I2C_Sda_Direction at TRISB2_bit;
sbit Soft_I2C_Scl_Direction at TRISB3_bit;
/** @} */


/*
 * Function for I2C controller configuration. It start I2C communication, 
 * addresses device, then desired register, and puts some value appropriate value in it.
 * At the end it stops the communication.
*/
void static I2C_Send_Message(unsigned short dev_addr, unsigned short reg_addr, unsigned short data_value)
{
    Soft_I2C_Start();
    Soft_I2C_Write(dev_addr);
    Soft_I2C_Write(reg_addr);
    Soft_I2C_Write(data_value);
    Soft_I2C_Stop();
}


/*
 * Function that initializes I2C communication. It inits I2C, then sets MODE1 register of
 * PCA9633 device with appropriate bit setting (AIx to 000, SLEEP to 0, SUBx to 000, ALLCALL to 1).
 * After that set LEDOUT register to 0xAA
*/
void initialize_car_drive(){
    Soft_I2C_Init();
    Delay_ms(100);
    I2C_Send_Message(DEVICE_ADDR, 0x00, 0x01);
    I2C_Send_Message(DEVICE_ADDR, 0xE8, 0xAA);
}

/*
 * Function for setting PWMx registers of PCA9633 to appropriate
 * values for going forward.
*/
void static forward()
{
    I2C_Send_Message(DEVICE_ADDR, 0x02, 0);
    I2C_Send_Message(DEVICE_ADDR, 0x03, SPEED);
    I2C_Send_Message(DEVICE_ADDR, 0x04, 0);
    I2C_Send_Message(DEVICE_ADDR, 0x05, SPEED);
}


/*
 * Function for setting PWMx registers of PCA9633 to appropriate
 * values for driving backwards.
*/
void static reverse()
{
    I2C_Send_Message(DEVICE_ADDR, 0x02, SPEED);
    I2C_Send_Message(DEVICE_ADDR, 0x03, 0);
    I2C_Send_Message(DEVICE_ADDR, 0x04, SPEED);
    I2C_Send_Message(DEVICE_ADDR, 0x05, 0);
}

/*
 * Function for setting PWMx registers of PCA9633 to appropriate
 * values for braking.
*/
void static brake()
{
    I2C_Send_Message(DEVICE_ADDR, 0x02, 0);
    I2C_Send_Message(DEVICE_ADDR, 0x03, 0);
    I2C_Send_Message(DEVICE_ADDR, 0x04, 0);
    I2C_Send_Message(DEVICE_ADDR, 0x05, 0);
}


/*
 * Function for setting PWMx registers of PCA9633 to appropriate
 * values for going left.
*/
void static left()
{
    I2C_Send_Message(DEVICE_ADDR, 0x02, 0);
    I2C_Send_Message(DEVICE_ADDR, 0x03, 0);
    I2C_Send_Message(DEVICE_ADDR, 0x04, 0);
    I2C_Send_Message(DEVICE_ADDR, 0x05, SPEED);

}


/*
 * Function for driving vehicle right. Setting PWMx registers of PCA9633 to appropriate
 * values for going right.
*/
void static right()
{
    I2C_Send_Message(DEVICE_ADDR, 0x02, 0);
    I2C_Send_Message(DEVICE_ADDR, 0x03, SPEED);
    I2C_Send_Message(DEVICE_ADDR, 0x04, 0);
    I2C_Send_Message(DEVICE_ADDR, 0x05, 0);

}


/*
 * Function for driving vehicle forward. This is just basically going forward.
*/
void drive_forward()
{
    forward();
}


/*
 * Function for driving vehicle backwards. This is just basically going reverse.
*/
void drive_reverse(){
    reverse();
}


/*
 * Function for stopping the vehicle.
*/
void stop()
{
    brake();
}

/*
 * Function for driving the vehicle 90 degrees to the left. This means driving
 * vehicle left for some time, needed for it to turn left 90 degrees, and then 
 * driving forward.
*/
void drive_full_left(){
    // go left 90 degress
    left();
    Delay_ms(1100);
    brake();

     // go forward
    drive_forward();

}



/*
 * Function for driving the vehicle 45 degrees to the left. This means driving
 * vehicle left for some time, needed for it to turn left 45 degrees, and then 
 * driving forward.
*/
void drive_small_left(){
    // go left 45 degress
    left();
    Delay_ms(850);
    brake();

    // go forward
    drive_forward();

}


/*
 * Function for driving the vehicle 90 degrees to the left. This means driving
 * vehicle left for some time, needed for it to turn left 90 degrees, and then 
 * driving forward.
*/
void drive_full_right(){
    right();
    Delay_ms(1100);
    brake();

    // go forward
    drive_forward();
}



/*
 * Function for driving the vehicle 90 degrees to the left. This means driving
 * vehicle left for some time, needed for it to turn left 90 degrees, and then 
 * driving forward.
*/
void drive_small_right(){
    right();
    Delay_ms(850);
    brake();

    // go forward
    drive_forward();
}
