AnjaDj/2D_Space_Mapping/2DSpaceMapping_B/firmware/testing/wheels_i2c/wheels.c

/**
 * @file wheels.c
 * 
 * @brief File containing testing program for driving the car.
 *
 * This file is used for initializing communication with driver 
 * board of the system, or precisely, with the I2C driver on the board
 * namely PCA9633 component. Several I2C configuration messages
 * are needed for component to initialize, in which some
 * configuration register are filled. After that I2C messages
 * that set register for driving can be sent.
*/

/** @brief I2C address of the device PCA9633*/
#define DEVICE_ADDR 0xE0

/**
 * @name I2C Communication
 * Enable Software I2C communication, through the desired pins
 * @{
*/
sbit Soft_I2C_Sda           at RB2_bit;
sbit Soft_I2C_Scl           at RB3_bit;
sbit Soft_I2C_Sda_Direction at TRISB2_bit;
sbit Soft_I2C_Scl_Direction at TRISB3_bit;
/** @} */


/**
 * Function that addresses device, then desired register, and puts some value in it 
 * @param dev_addr   Address of the device PCA9633
 * @param reg_addr   Address of the desired register of PCA9633
 * @param data_value Value to be written into selected register
*/
void I2C_Send_Message(unsigned short dev_addr, unsigned short reg_addr, unsigned short data_value)
{
     Soft_I2C_Start();
     Soft_I2C_Write(dev_addr);
     Soft_I2C_Write(reg_addr);
     Soft_I2C_Write(data_value);
     Soft_I2C_Stop();
}


/**
 * @brief Main function, entry point of the program
 * 
 * Main function of the program, does all the configuration MCU work
 * and configures also PCA9633, and then drives the car forward.
*/
void main() 
{

	/* Set all analog pins as digital, set port B pins as 
	* output and initialize to zero 
	*/
	AD1PCFG = 0xFFFF; 
	LATB = 0;
	TRISB = 0;

	/* Software I2C initializiton */
	Soft_I2C_Init();
	/* Wait some time to be sure everythin is up and running */
	Delay_ms(100);

	/* Set MODE1 register of PCA9633
	* AIx                   - Auto-Increment disabled
	* SLEEP bit set to 0    - Normal Mode 
	* SUBx bit set to 0     - PCA does not respond to subadresses
	* ALLCALL bit set to 1  - PCA9633 responds to ALLCALL address (0xE0)
	*/
	I2C_Send_Message(DEVICE_ADDR, 0x00, 0x01);


	/* Set LEDOUT register of PCA9633
	* LEDx output state control - all set to 0x10 which results 
	* in 0xAA value put into LEDOUT register 
	*/
	I2C_Send_Message(DEVICE_ADDR, 0xE8, 0xAA);

	Delay_ms(100);

	/* Set PWMx (x = 0, 1, 2, 3) registers to values according to datasheet 
	*in order for vehice to go forward
	*/
	I2C_Send_Message(DEVICE_ADDR, 0x02, 0);
	I2C_Send_Message(DEVICE_ADDR, 0x03, 255);
	I2C_Send_Message(DEVICE_ADDR, 0x04, 0);
	I2C_Send_Message(DEVICE_ADDR, 0x05, 255);

	while(1);


}
